NikPanda1537/Proyecto-Robotica-y-Dise-o-mecatronico/README.md

# Robotic_and_Mechatronic_Design_Project
