NikPanda1537/Proyecto-Robotica-y-Dise-o-mecatronico/URDF/Ensamblaje.SLDASM

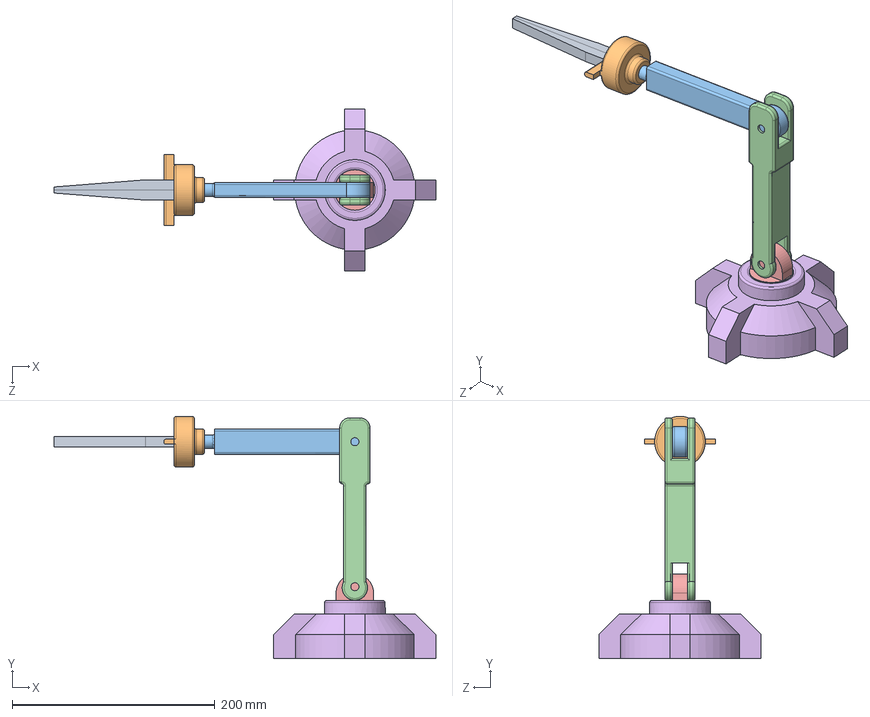
[picture p29: CAD file, 2024-06-11]
URDF/Ensamblaje.SLDASM
376.6 x 238.9 x 160.0 mm
Base
union base eslabon
Eslabon1
Eslabon2
Eslabon pinza
pinza x 2
