NikPanda1537/Proyecto-Robotica-y-Dise-o-mecatronico/Piezas/Cuerpo robot/Encaje_servo.SLDPRT

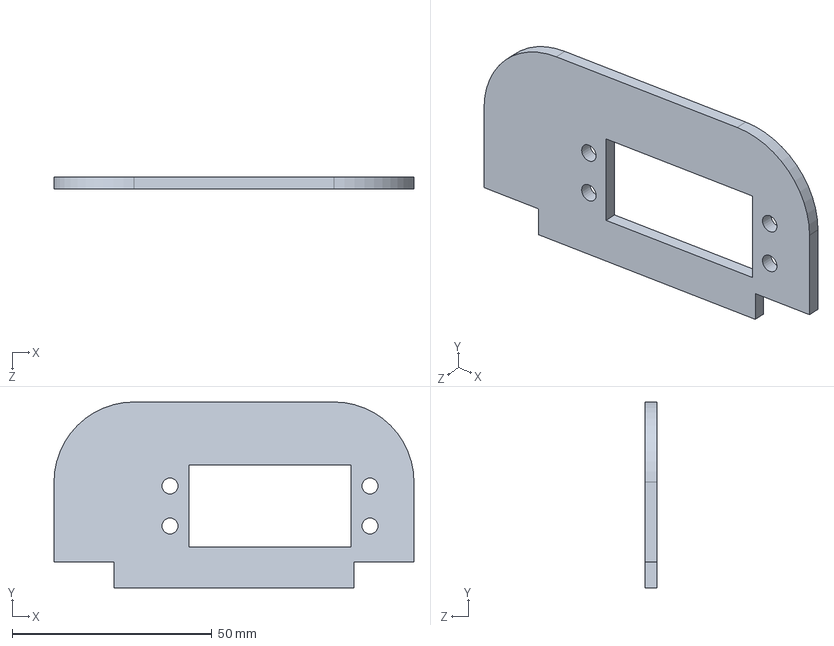
[picture p31: CAD file, 2024-06-11]
Piezas/Cuerpo robot/Encaje_servo.SLDPRT
90.0 x 46.5 x 3.00 mm
