NikPanda1537/Proyecto-Robotica-y-Dise-o-mecatronico/Piezas/Garra/Garra_1.SLDPRT

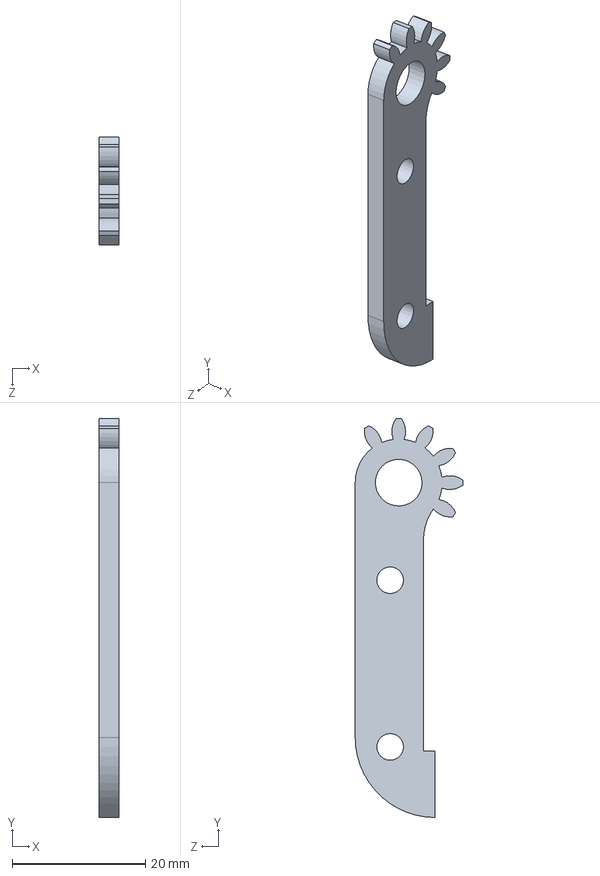
[picture p32: CAD file, 2024-06-11]
Piezas/Garra/Garra_1.SLDPRT
3.00 x 59.8 x 16.1 mm
