NikPanda1537/Proyecto-Robotica-y-Dise-o-mecatronico/Piezas/Tornillos y tuercas/Tornillo.SLDPRT

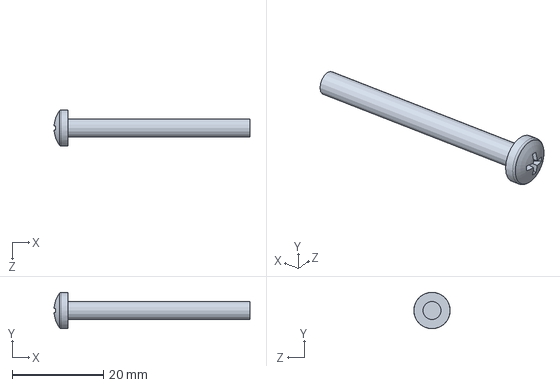
[picture p33: CAD file, 2024-06-11]
Piezas/Tornillos y tuercas/Tornillo.SLDPRT
43.1 x 8.00 x 8.00 mm
