NikPanda1537/Proyecto-Robotica-y-Dise-o-mecatronico/URDF/union base eslabon.SLDPRT

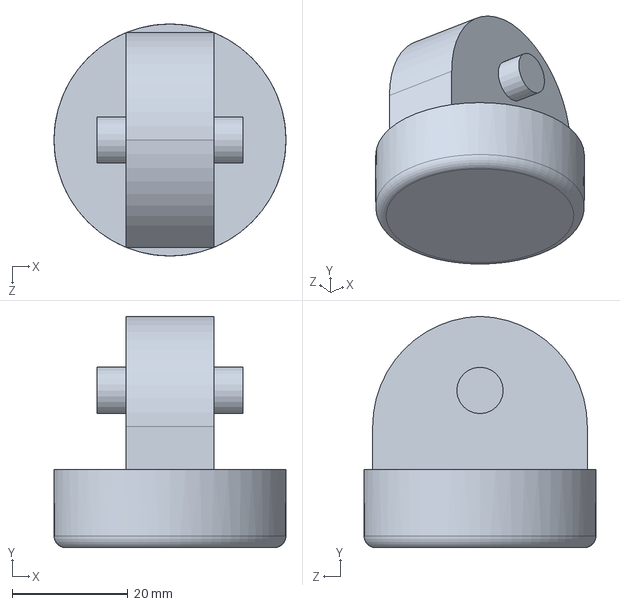
[picture p34: CAD file, 2024-06-11]
URDF/union base eslabon.SLDPRT
40.0 x 39.9 x 40.0 mm
