NikPanda1537/Proyecto-Robotica-y-Dise-o-mecatronico/ws_robot/install/modelo_robot/share/modelo_robot/meshes/Link_5.STL

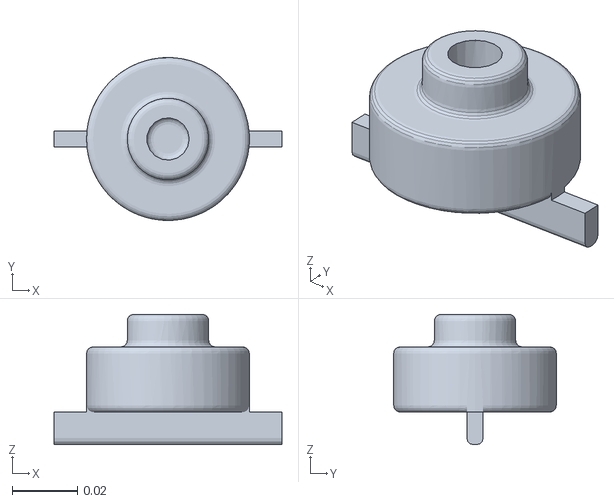
[picture p35: CAD file, 2024-06-12]
ws_robot/install/modelo_robot/share/modelo_robot/meshes/Link_5.STL
0.07 x 0.05 x 0.04
