NikPanda1537/Proyecto-Robotica-y-Dise-o-mecatronico/Piezas/Cuerpo robot/Base_4.SLDPRT

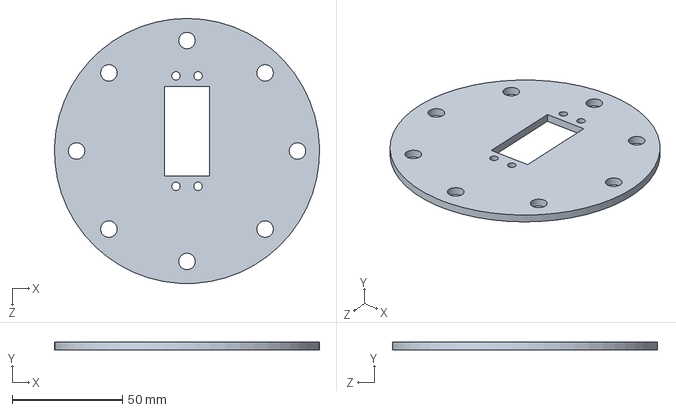
[picture p37: CAD file, 2024-06-11]
Piezas/Cuerpo robot/Base_4.SLDPRT
119.9 x 3.50 x 120.0 mm
