NikPanda1537/Proyecto-Robotica-y-Dise-o-mecatronico/Piezas/Garra/Garra_5.SLDPRT

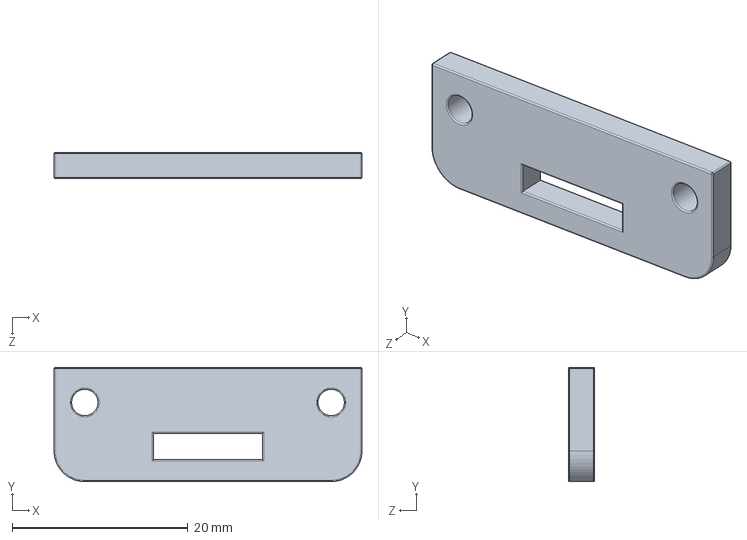
[picture p38: CAD file, 2024-06-11]
Piezas/Garra/Garra_5.SLDPRT
35.0 x 13.0 x 3.00 mm
