NikPanda1537/Proyecto-Robotica-y-Dise-o-mecatronico/Piezas/Tornillos y tuercas/Tornillo3.SLDPRT

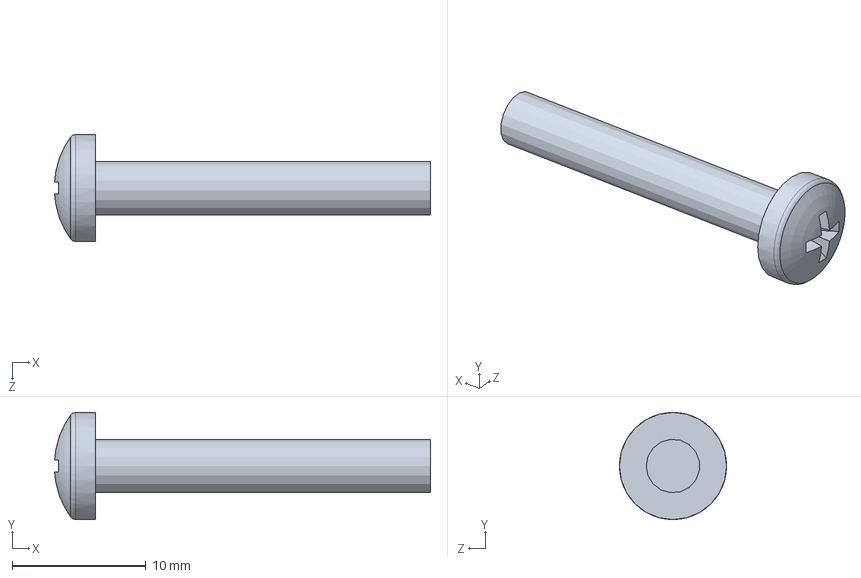
[picture p39: CAD file, 2024-06-11]
Piezas/Tornillos y tuercas/Tornillo3.SLDPRT
28.1 x 8.00 x 8.00 mm
