NikPanda1537/Proyecto-Robotica-y-Dise-o-mecatronico/URDF/Eslabon2.SLDPRT

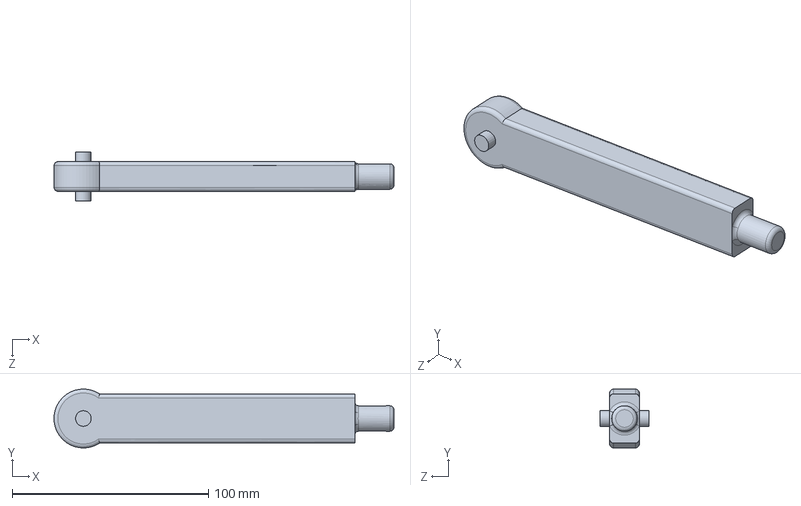
[picture p40: CAD file, 2024-06-11]
URDF/Eslabon2.SLDPRT
173.3 x 30.0 x 25.1 mm
