NikPanda1537/Proyecto-Robotica-y-Dise-o-mecatronico/ws_robot/install/modelo_robot/share/modelo_robot/meshes/base_link.STL

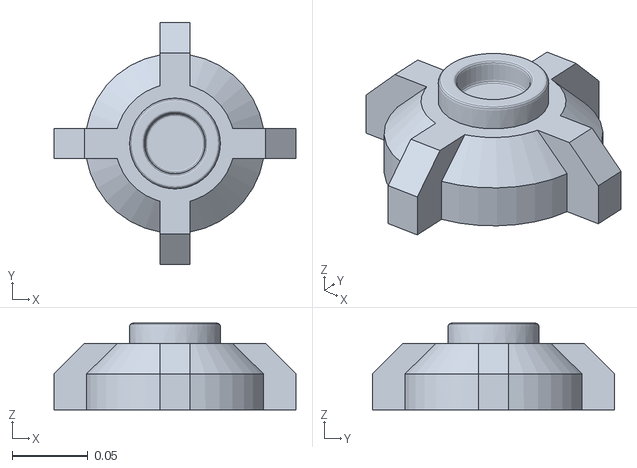
[picture p41: CAD file, 2024-06-11]
ws_robot/install/modelo_robot/share/modelo_robot/meshes/base_link.STL
0.16 x 0.16 x 0.0573
