NikPanda1537/Proyecto-Robotica-y-Dise-o-mecatronico/ws_robot/src/modelo_robot/meshes/Link_6.STL

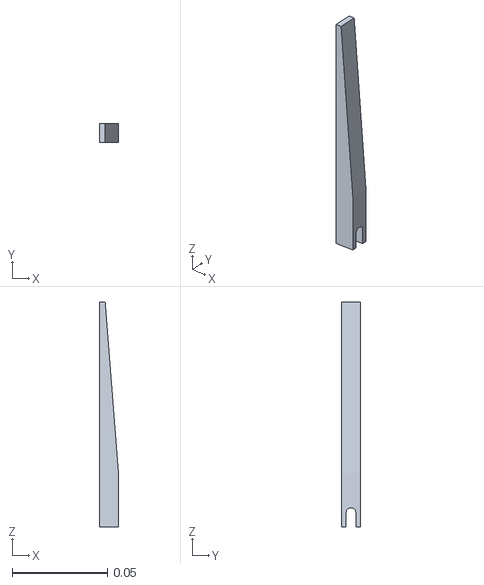
[picture p42: CAD file, 2024-06-11]
ws_robot/src/modelo_robot/meshes/Link_6.STL
0.01 x 0.01 x 0.118
