NikPanda1537/Proyecto-Robotica-y-Dise-o-mecatronico/Piezas/Cuerpo robot/Eslabon4_3.SLDPRT

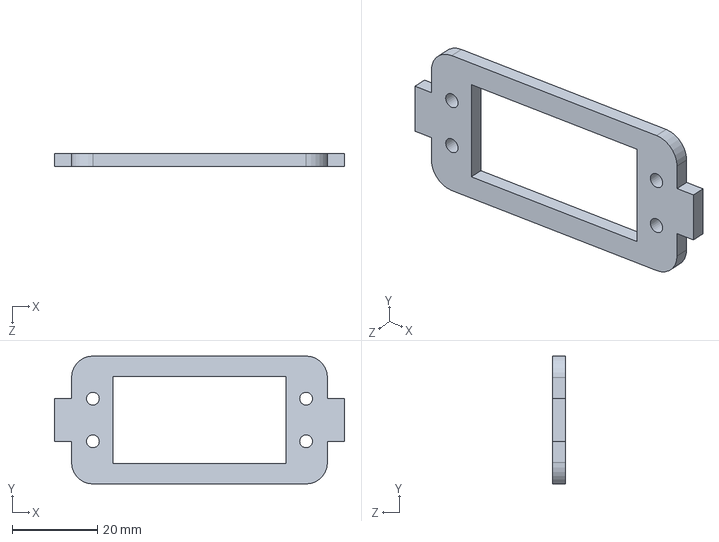
[picture p44: CAD file, 2024-06-11]
Piezas/Cuerpo robot/Eslabon4_3.SLDPRT
68.0 x 30.0 x 3.00 mm
