NikPanda1537/Proyecto-Robotica-y-Dise-o-mecatronico/Piezas/Garra/Garra_4.SLDPRT

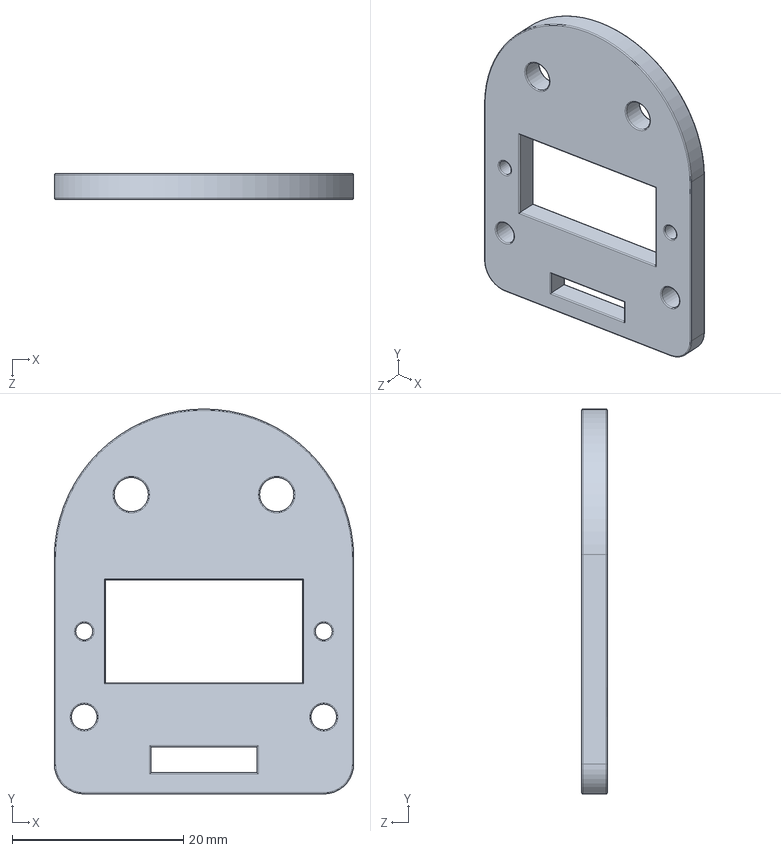
[picture p45: CAD file, 2024-06-11]
Piezas/Garra/Garra_4.SLDPRT
35.0 x 45.0 x 3.00 mm
