NikPanda1537/Proyecto-Robotica-y-Dise-o-mecatronico/Piezas/Tornillos y tuercas/Tornillo2.SLDPRT

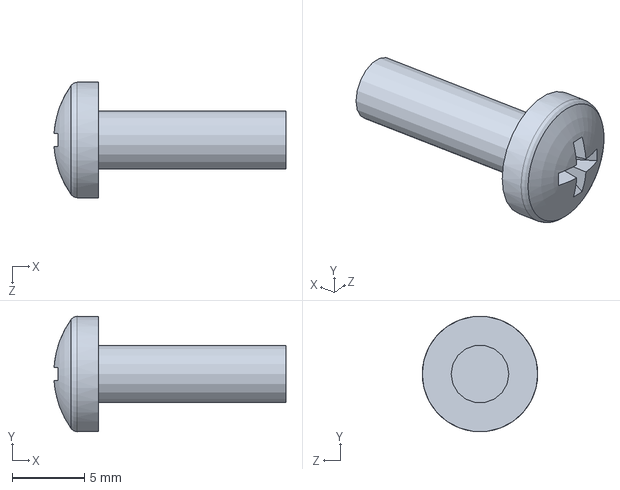
[picture p46: CAD file, 2024-06-11]
Piezas/Tornillos y tuercas/Tornillo2.SLDPRT
16.1 x 8.00 x 8.00 mm
