NikPanda1537/Proyecto-Robotica-y-Dise-o-mecatronico/URDF/Eslabon1.SLDPRT

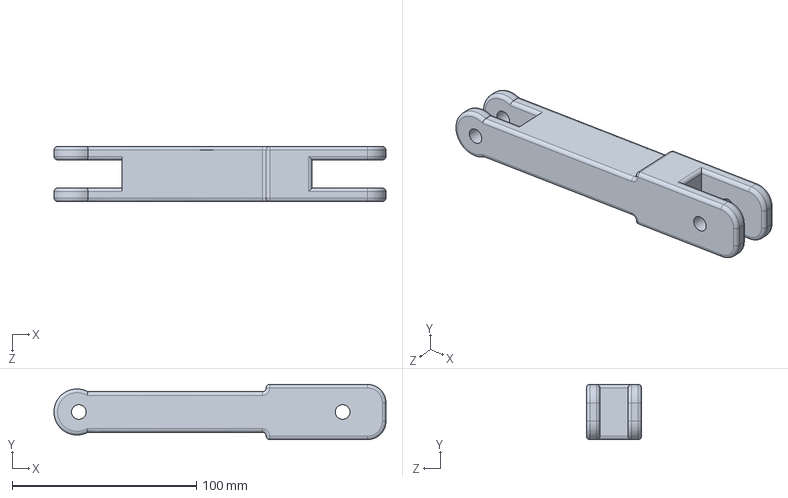
[picture p47: CAD file, 2024-06-11]
URDF/Eslabon1.SLDPRT
180.0 x 30.0 x 30.0 mm
