NikPanda1537/Proyecto-Robotica-y-Dise-o-mecatronico/ws_robot/install/modelo_robot/share/modelo_robot/meshes/Link_3.STL

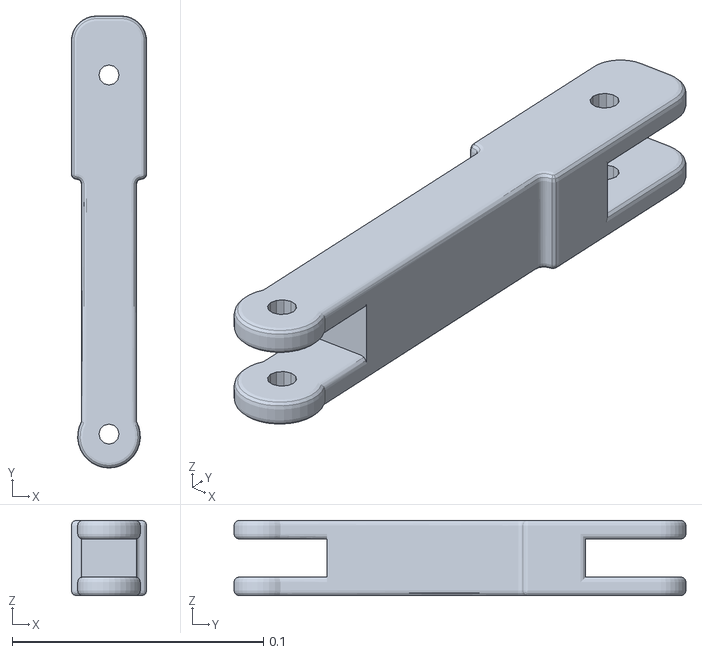
[picture p48: CAD file, 2024-06-11]
ws_robot/install/modelo_robot/share/modelo_robot/meshes/Link_3.STL
0.03 x 0.18 x 0.03
