NikPanda1537/Proyecto-Robotica-y-Dise-o-mecatronico/Piezas/Cuerpo robot/Servomotor.SLDPRT

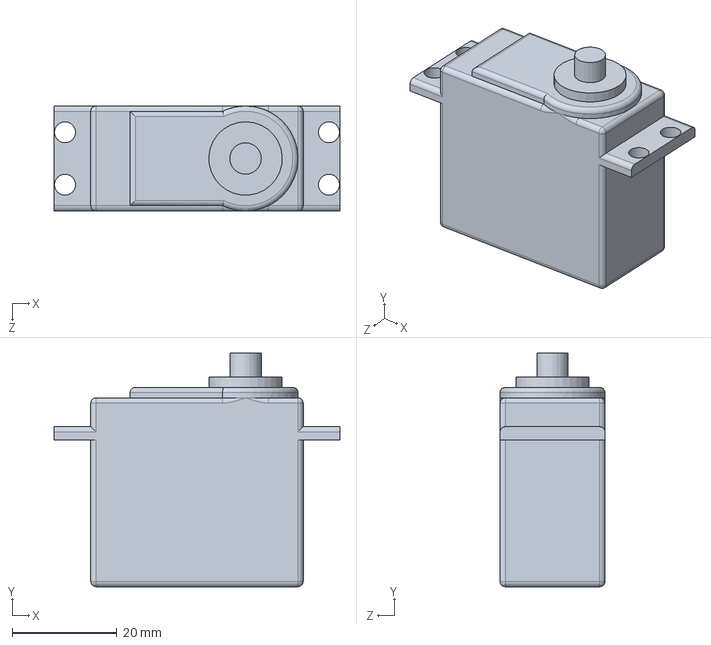
[picture p50: CAD file, 2024-06-11]
Piezas/Cuerpo robot/Servomotor.SLDPRT
54.5 x 44.5 x 20.0 mm
