NikPanda1537/Proyecto-Robotica-y-Dise-o-mecatronico/Piezas/Garra/Garra_6.SLDPRT

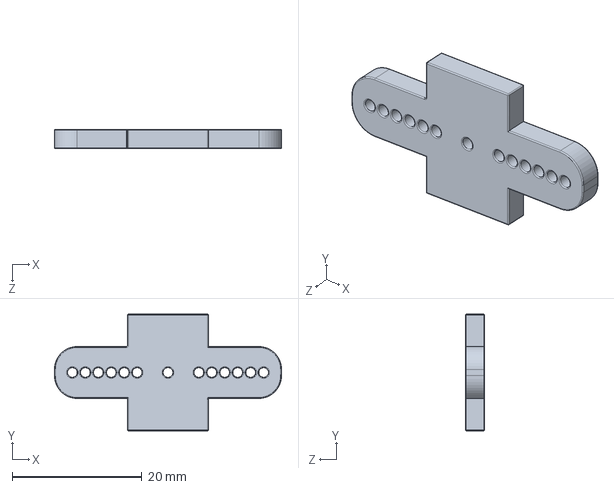
[picture p51: CAD file, 2024-06-11]
Piezas/Garra/Garra_6.SLDPRT
35.0 x 18.0 x 3.00 mm
