NikPanda1537/Proyecto-Robotica-y-Dise-o-mecatronico/Piezas/Tornillos y tuercas/Tuerca.SLDPRT

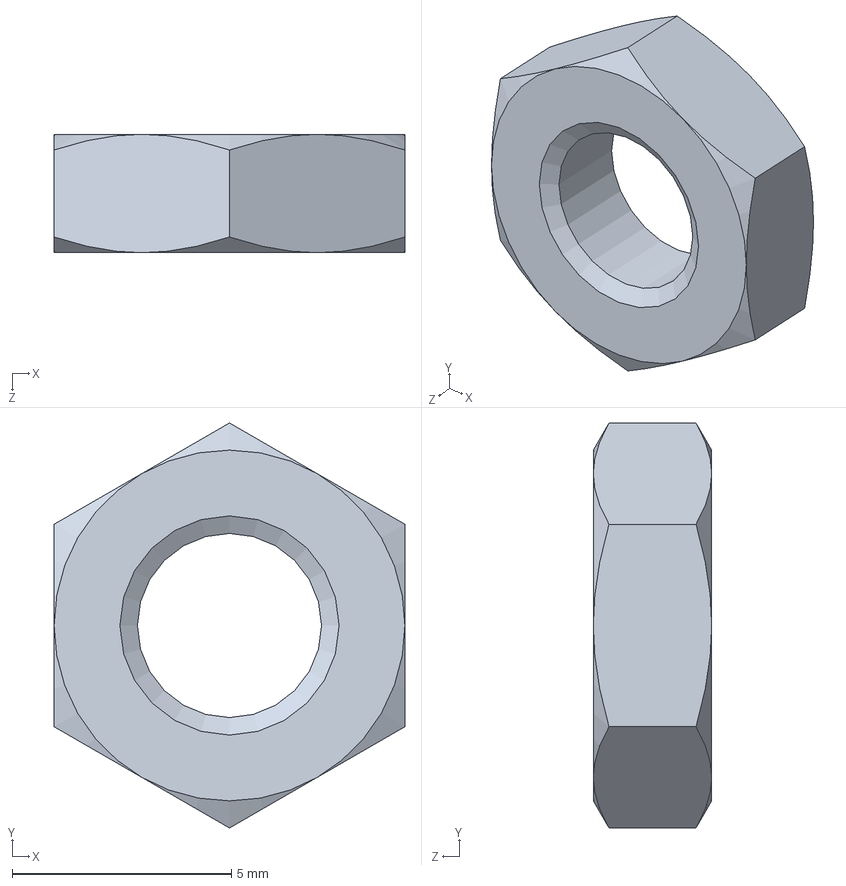
[picture p52: CAD file, 2024-06-11]
Piezas/Tornillos y tuercas/Tuerca.SLDPRT
8.00 x 9.24 x 2.70 mm
