NikPanda1537/Proyecto-Robotica-y-Dise-o-mecatronico/ws_robot/install/modelo_robot/share/modelo_robot/meshes/Link_4.STL

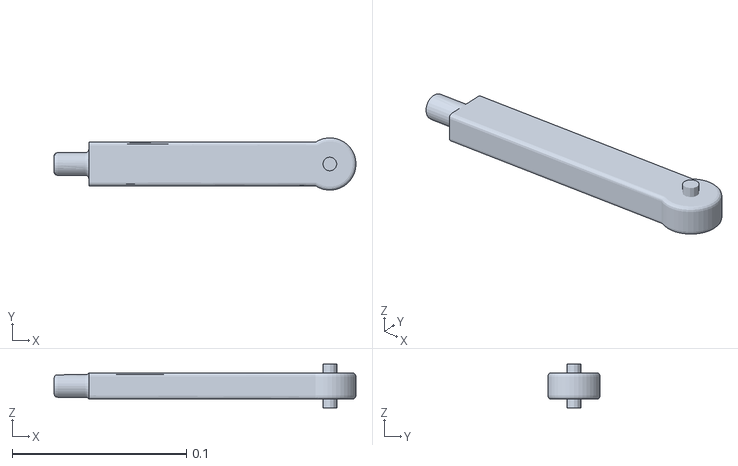
[picture p53: CAD file, 2024-06-11]
ws_robot/install/modelo_robot/share/modelo_robot/meshes/Link_4.STL
0.173 x 0.0299 x 0.0252
