NikPanda1537/Proyecto-Robotica-y-Dise-o-mecatronico/Archivos para Corte laser/Encaje_servo2_3x4.DXF

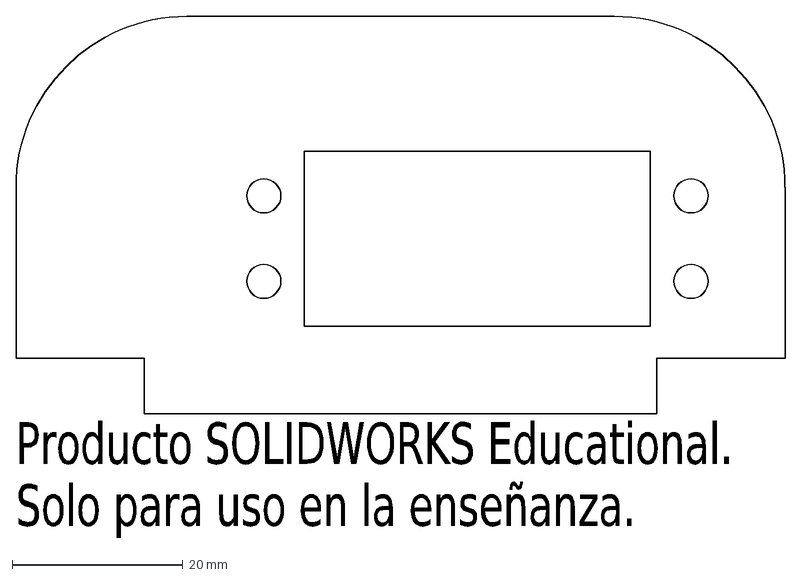
[picture p54: CAD file, 2024-06-11]
Archivos para Corte laser/Encaje_servo2_3x4.DXF
Producto SOLIDWORKS Educational.
Solo para uso en la enseñanza.
