NikPanda1537/Proyecto-Robotica-y-Dise-o-mecatronico/Piezas/Garra/Garra_7.SLDPRT

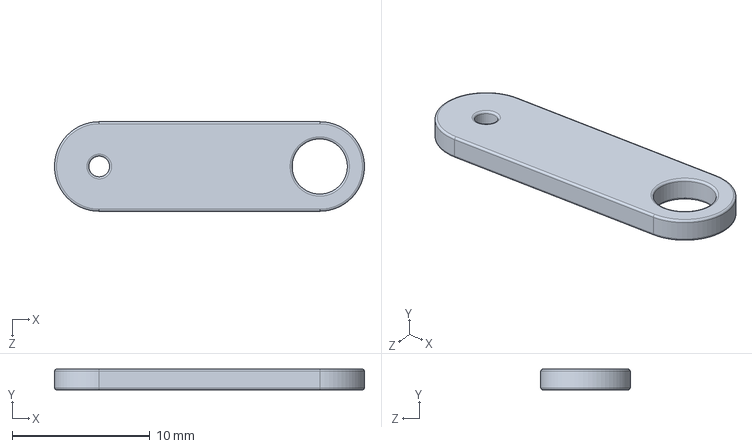
[picture p56: CAD file, 2024-06-11]
Piezas/Garra/Garra_7.SLDPRT
22.5 x 1.50 x 6.50 mm
