NikPanda1537/Proyecto-Robotica-y-Dise-o-mecatronico/URDF/pinza.SLDPRT

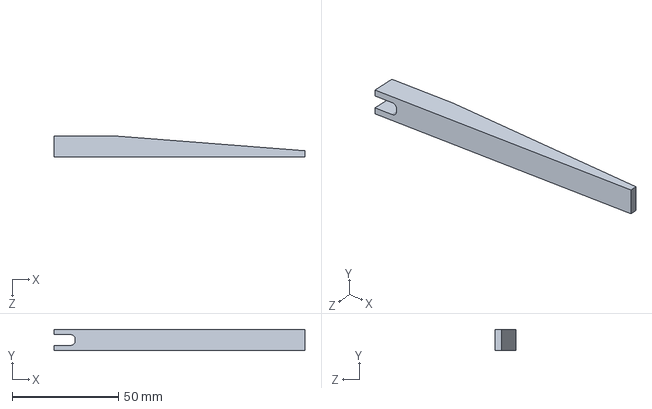
[picture p57: CAD file, 2024-06-11]
URDF/pinza.SLDPRT
118.3 x 10.0 x 10.0 mm
