NikPanda1537/Proyecto-Robotica-y-Dise-o-mecatronico/ws_robot/install/modelo_robot/share/modelo_robot/meshes/Link_2.STL

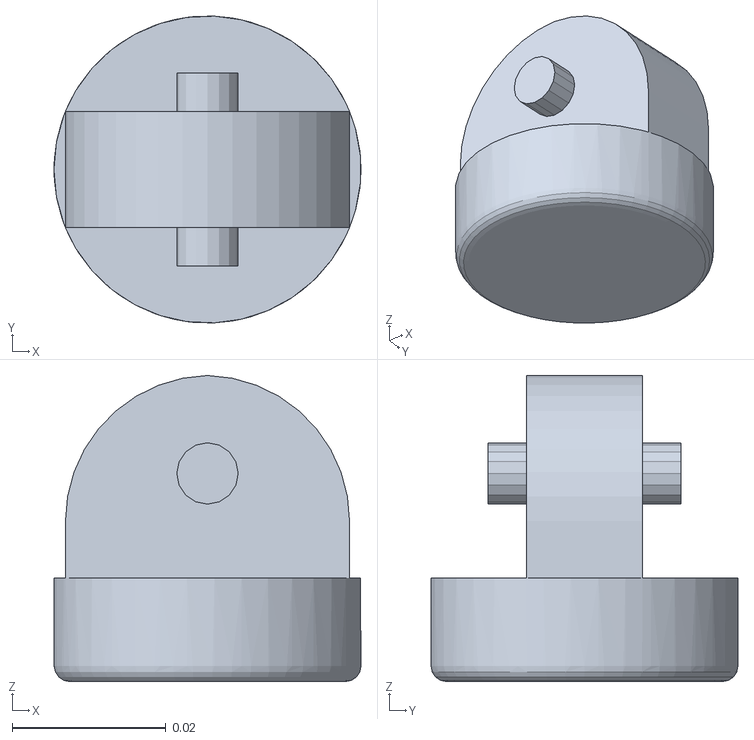
[picture p58: CAD file, 2024-06-11]
ws_robot/install/modelo_robot/share/modelo_robot/meshes/Link_2.STL
0.04 x 0.04 x 0.0399
