NikPanda1537/Proyecto-Robotica-y-Dise-o-mecatronico/Piezas/Cuerpo robot/Eslabon4_1.SLDPRT

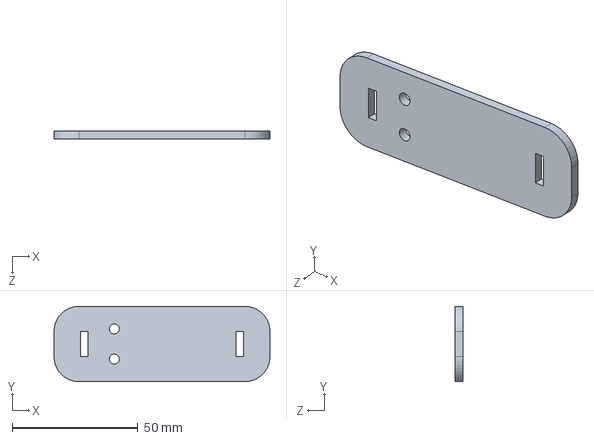
[picture p60: CAD file, 2024-06-11]
Piezas/Cuerpo robot/Eslabon4_1.SLDPRT
86.0 x 30.0 x 3.00 mm
