NikPanda1537/Proyecto-Robotica-y-Dise-o-mecatronico/Piezas/Garra/Garra_3.SLDPRT

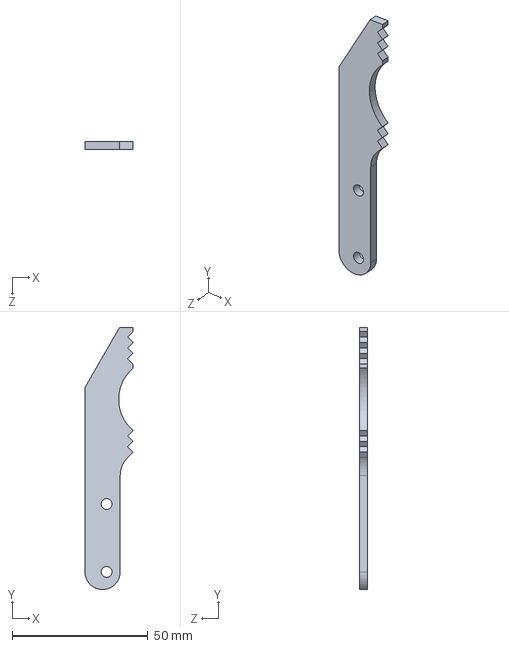
[picture p61: CAD file, 2024-06-11]
Piezas/Garra/Garra_3.SLDPRT
17.8 x 96.5 x 3.00 mm
