NikPanda1537/Proyecto-Robotica-y-Dise-o-mecatronico/URDF/Base.SLDPRT

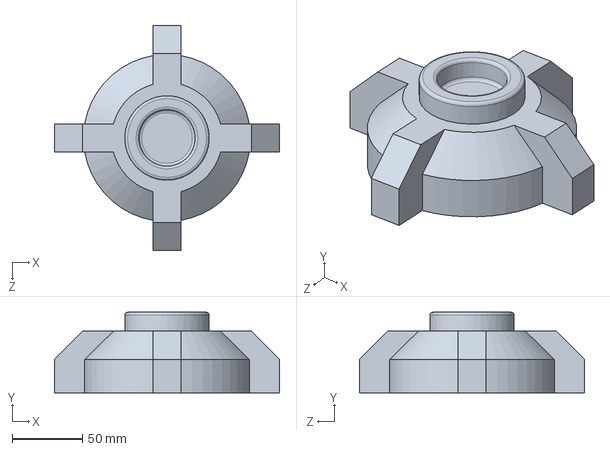
[picture p62: CAD file, 2024-06-11]
URDF/Base.SLDPRT
160.0 x 57.3 x 160.0 mm
