NikPanda1537/Proyecto-Robotica-y-Dise-o-mecatronico/Piezas/Cuerpo robot/Eslabon2_parte2.SLDPRT

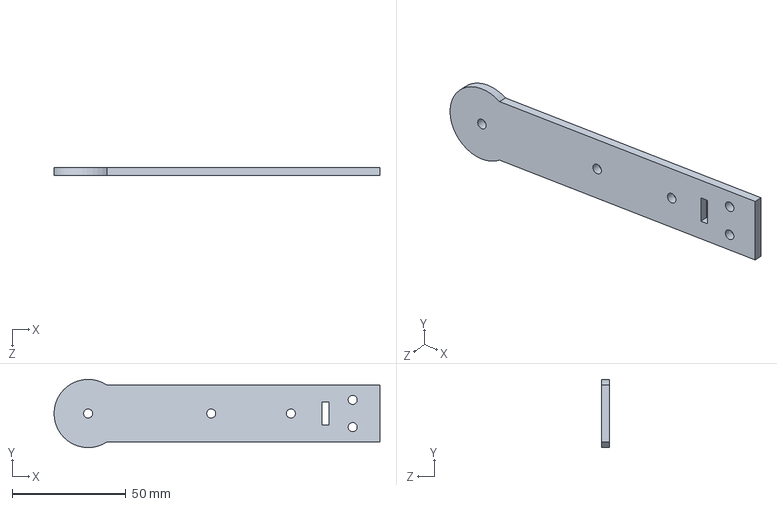
[picture p64: CAD file, 2024-06-11]
Piezas/Cuerpo robot/Eslabon2_parte2.SLDPRT
143.3 x 30.0 x 3.50 mm
