NikPanda1537/Proyecto-Robotica-y-Dise-o-mecatronico/Piezas/Garra/Garra_2.SLDPRT

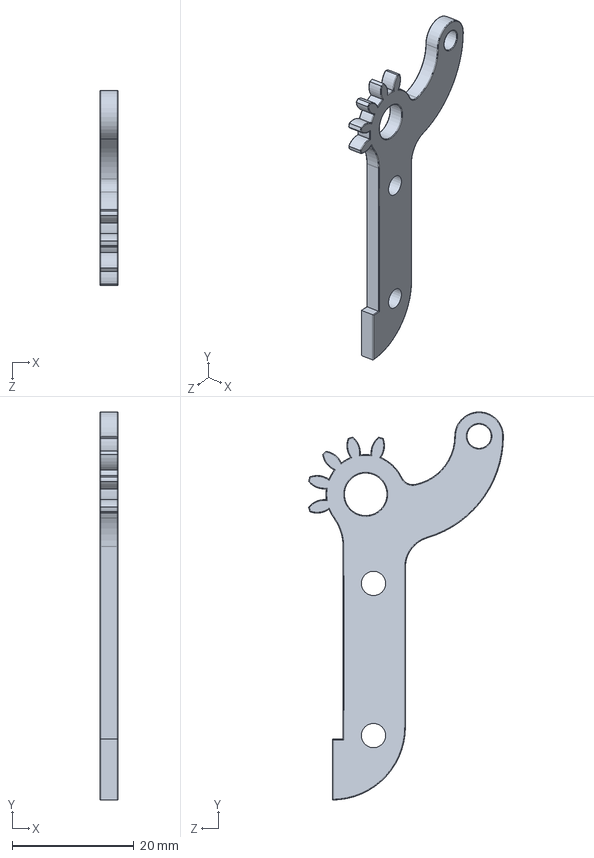
[picture p65: CAD file, 2024-06-11]
Piezas/Garra/Garra_2.SLDPRT
3.00 x 63.8 x 32.0 mm
