NikPanda1537/Proyecto-Robotica-y-Dise-o-mecatronico/URDF/Eslabon pinza.SLDPRT

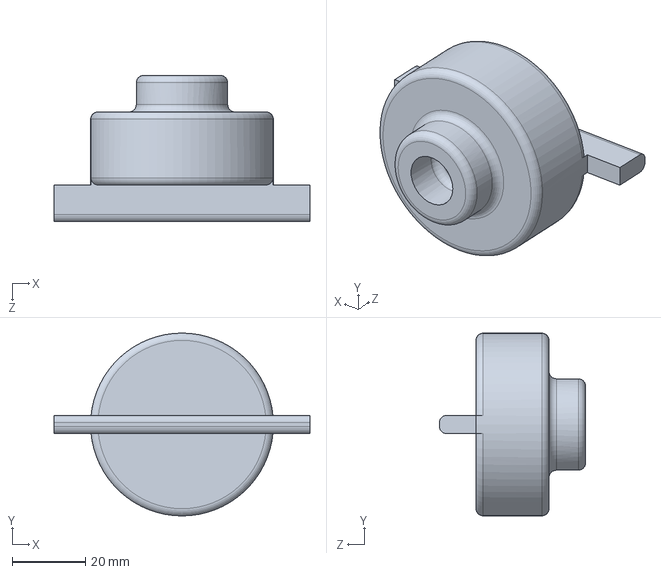
[picture p66: CAD file, 2024-06-11]
URDF/Eslabon pinza.SLDPRT
70.0 x 50.0 x 40.0 mm
