NikPanda1537/Proyecto-Robotica-y-Dise-o-mecatronico/Piezas/Cuerpo robot/Base_articulacion_1.SLDPRT

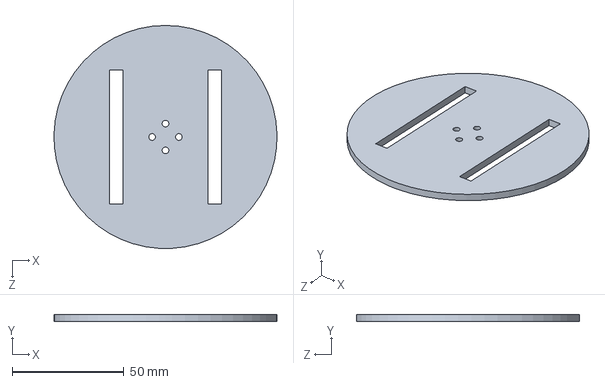
[picture p68: CAD file, 2024-06-11]
Piezas/Cuerpo robot/Base_articulacion_1.SLDPRT
100.0 x 3.00 x 100.0 mm
