NikPanda1537/Proyecto-Robotica-y-Dise-o-mecatronico/Piezas/Cuerpo robot/Eslabon1_parte1.SLDPRT

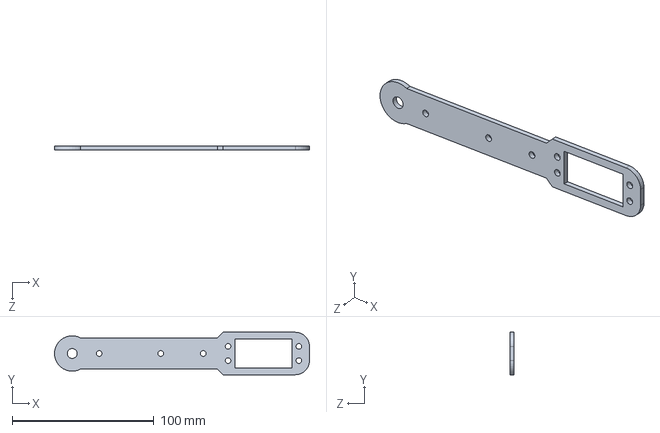
[picture p71: CAD file, 2024-06-11]
Piezas/Cuerpo robot/Eslabon1_parte1.SLDPRT
180.0 x 30.0 x 3.00 mm
