NikPanda1537/Proyecto-Robotica-y-Dise-o-mecatronico/Archivos para Corte laser/PTN8x1.DXF

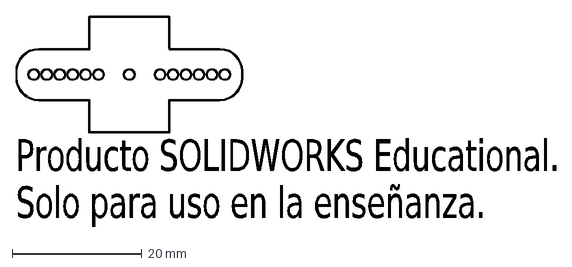
[picture p74: CAD file, 2024-06-11]
Archivos para Corte laser/PTN8x1.DXF
Producto SOLIDWORKS Educational.
Solo para uso en la enseñanza.
