NikPanda1537/Proyecto-Robotica-y-Dise-o-mecatronico/Piezas/Cuerpo robot/Eslabon4_2.SLDPRT

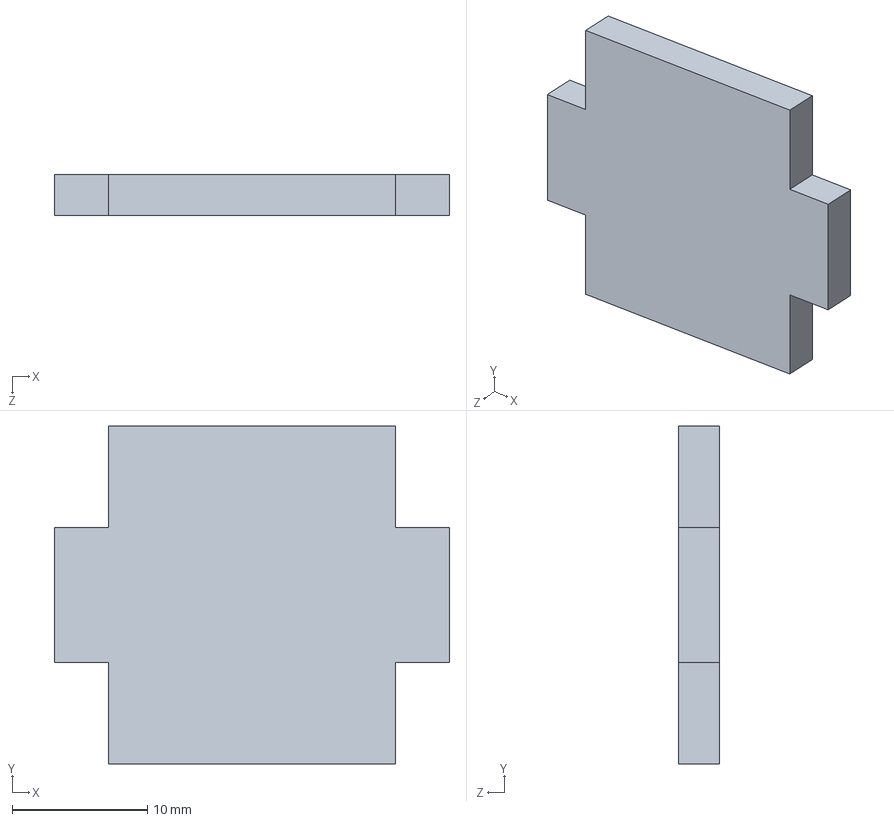
[picture p75: CAD file, 2024-06-11]
Piezas/Cuerpo robot/Eslabon4_2.SLDPRT
29.2 x 25.0 x 3.00 mm
