NikPanda1537/Proyecto-Robotica-y-Dise-o-mecatronico/Archivos para Corte laser/PTN4_x1.DXF

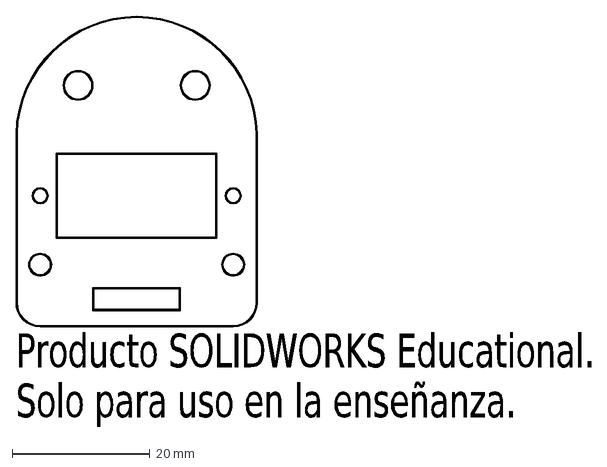
[picture p76: CAD file, 2024-06-11]
Archivos para Corte laser/PTN4_x1.DXF
Producto SOLIDWORKS Educational.
Solo para uso en la enseñanza.
