NikPanda1537/Proyecto-Robotica-y-Dise-o-mecatronico/Piezas/Cuerpo robot/Base_2.SLDPRT

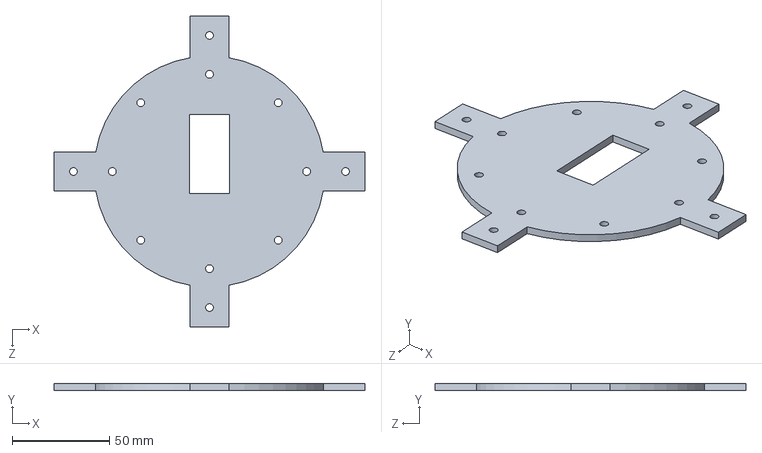
[picture p77: CAD file, 2024-06-11]
Piezas/Cuerpo robot/Base_2.SLDPRT
160.0 x 3.50 x 160.0 mm
