NikPanda1537/Proyecto-Robotica-y-Dise-o-mecatronico/Archivos para Corte laser/Base_articulacion1x2.DXF

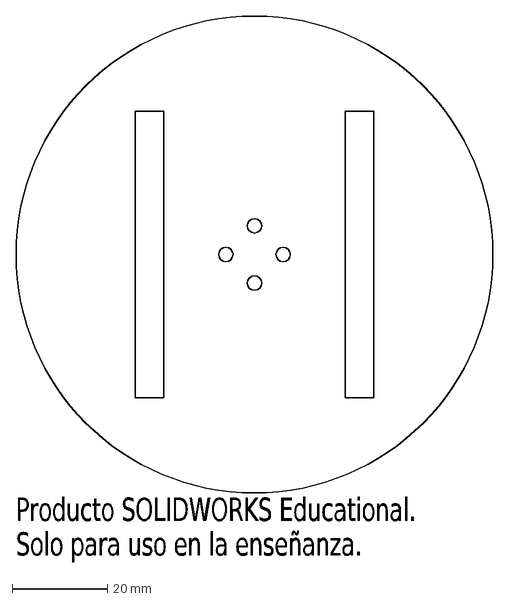
[picture p79: CAD file, 2024-06-11]
Archivos para Corte laser/Base_articulacion1x2.DXF
Producto SOLIDWORKS Educational.
Solo para uso en la enseñanza.
