NikPanda1537/Proyecto-Robotica-y-Dise-o-mecatronico/Archivos para Corte laser/Eslabon4_1x2.DXF

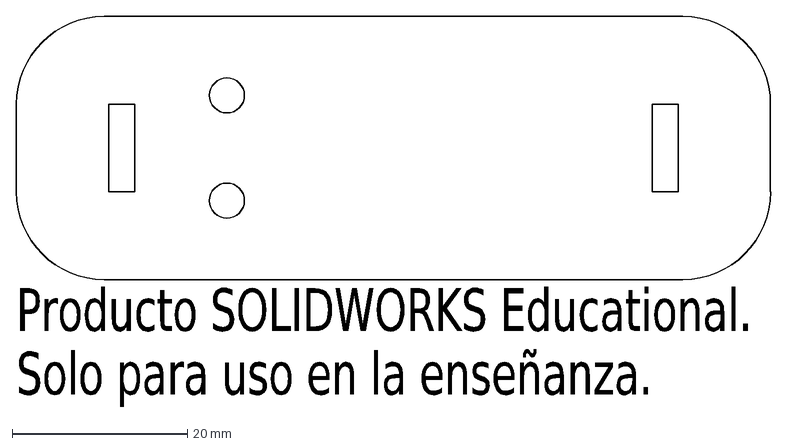
[picture p82: CAD file, 2024-06-11]
Archivos para Corte laser/Eslabon4_1x2.DXF
Producto SOLIDWORKS Educational.
Solo para uso en la enseñanza.
