NikPanda1537/Proyecto-Robotica-y-Dise-o-mecatronico/Archivos para Corte laser/Eslabon2_parte2x1.DXF

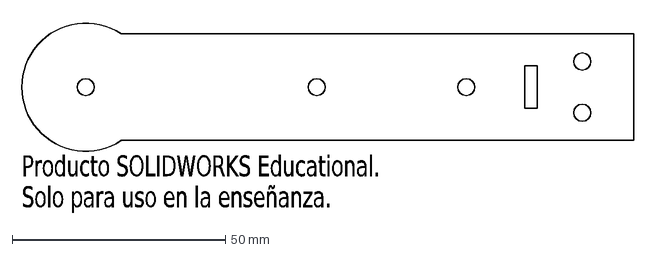
[picture p83: CAD file, 2024-06-11]
Archivos para Corte laser/Eslabon2_parte2x1.DXF
Producto SOLIDWORKS Educational.
Solo para uso en la enseñanza.
