NikPanda1537/Proyecto-Robotica-y-Dise-o-mecatronico/Archivos para Corte laser/eslabon4_2x2.DXF

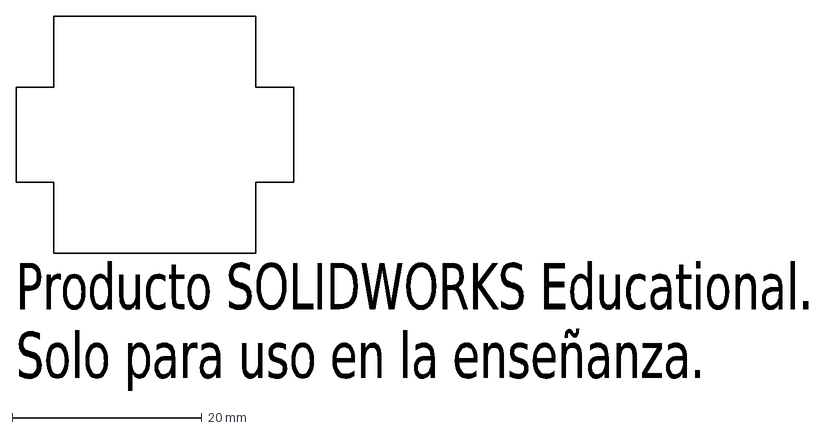
[picture p85: CAD file, 2024-06-11]
Archivos para Corte laser/eslabon4_2x2.DXF
Producto SOLIDWORKS Educational.
Solo para uso en la enseñanza.
