NikPanda1537/Proyecto-Robotica-y-Dise-o-mecatronico/Piezas/Ensamble/Ensamblaje Proyecto.SLDASM

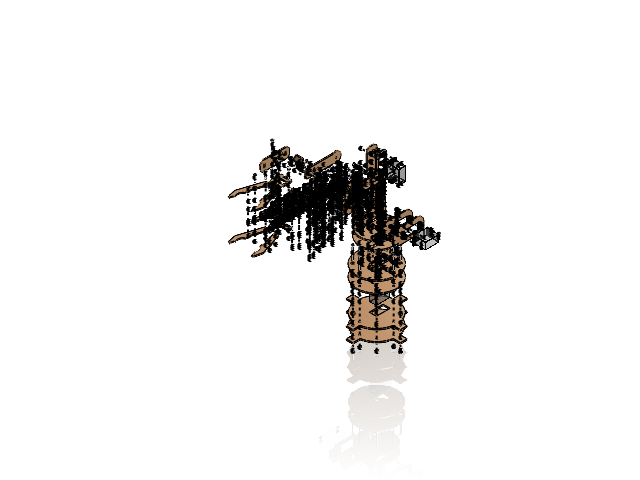
[picture p86: CAD file, 2024-06-12]
Piezas/Ensamble/Ensamblaje Proyecto.SLDASM
Base_1
Base_2
Base_3
Base_4
Base_articulacion_1 x 2
Encaje_servo x 4
Eslabon1_parte1
Eslabon1_parte2
Eslabon2_Parte1
Eslabon2_parte2
Eslabon4_1 x 2
Eslabon4_2 x 2
Eslabon4_3
Garra_2
Garra_3 x 4
Garra_4
Garra_5
Garra_6
Garra_7
Garra_8 x 2
Servomotor x 5
pan cross head_am x 49
hex nut jam_am x 65
engrane servo
punta x 2
Garra_1
carcasa
carcasa 2 servo
cover servo
engranaje servo
