NikPanda1537/Proyecto-Robotica-y-Dise-o-mecatronico/(list of files, cad)

Other CAD files:
ws_robot/src/modelo_robot/meshes/Link_7.STL
ws_robot/install/modelo_robot/share/modelo_robot/meshes/Link_7.STL
Piezas/Cuerpo robot/Base_3.SLDPRT
Piezas/Cuerpo robot/Eslabon2_Parte1.SLDPRT
Planos/Planos individuales/Cuerpo robot/Base_1.SLDDRW
Planos/Planos individuales/Cuerpo robot/Base_2.SLDDRW
Planos/Planos individuales/Cuerpo robot/Base_3.SLDDRW
Planos/Planos individuales/Cuerpo robot/Base_4.SLDDRW
Planos/Planos individuales/Cuerpo robot/Base_articulacion1.SLDDRW
Planos/Planos individuales/Cuerpo robot/Encaje_servo.SLDDRW
Planos/Planos individuales/Cuerpo robot/Eslabon1_parte1.SLDDRW
Planos/Planos individuales/Cuerpo robot/Eslabon1_parte2.SLDDRW
Planos/Planos individuales/Cuerpo robot/Eslabon2_parte1.SLDDRW
Planos/Planos individuales/Cuerpo robot/Eslabon2_parte2.SLDDRW
Planos/Planos individuales/Cuerpo robot/Eslabon4_1.SLDDRW
Planos/Planos individuales/Cuerpo robot/Servomotor.SLDDRW
Planos/Planos individuales/Cuerpo robot/eslabon4_2.SLDDRW
Planos/Planos individuales/Cuerpo robot/eslabon4_3.SLDDRW
Planos/Planos individuales/Ensamble/Plano, ensamblaje.SLDDRW
Planos/Planos individuales/Ensamble/Vista explosionada.SLDDRW
Planos/Planos individuales/Garra/Garra_1.SLDDRW
Planos/Planos individuales/Garra/Garra_2.SLDDRW
Planos/Planos individuales/Garra/Garra_3.SLDDRW
Planos/Planos individuales/Garra/Garra_4.SLDDRW
Planos/Planos individuales/Garra/Garra_5.SLDDRW
Planos/Planos individuales/Garra/Garra_6.SLDDRW
Planos/Planos individuales/Garra/Garra_7.SLDDRW
