NikPanda1537/Proyecto-Robotica-y-Dise-o-mecatronico/Planos/Pdf con todos los planos/Todos los planos.pdf

23

8

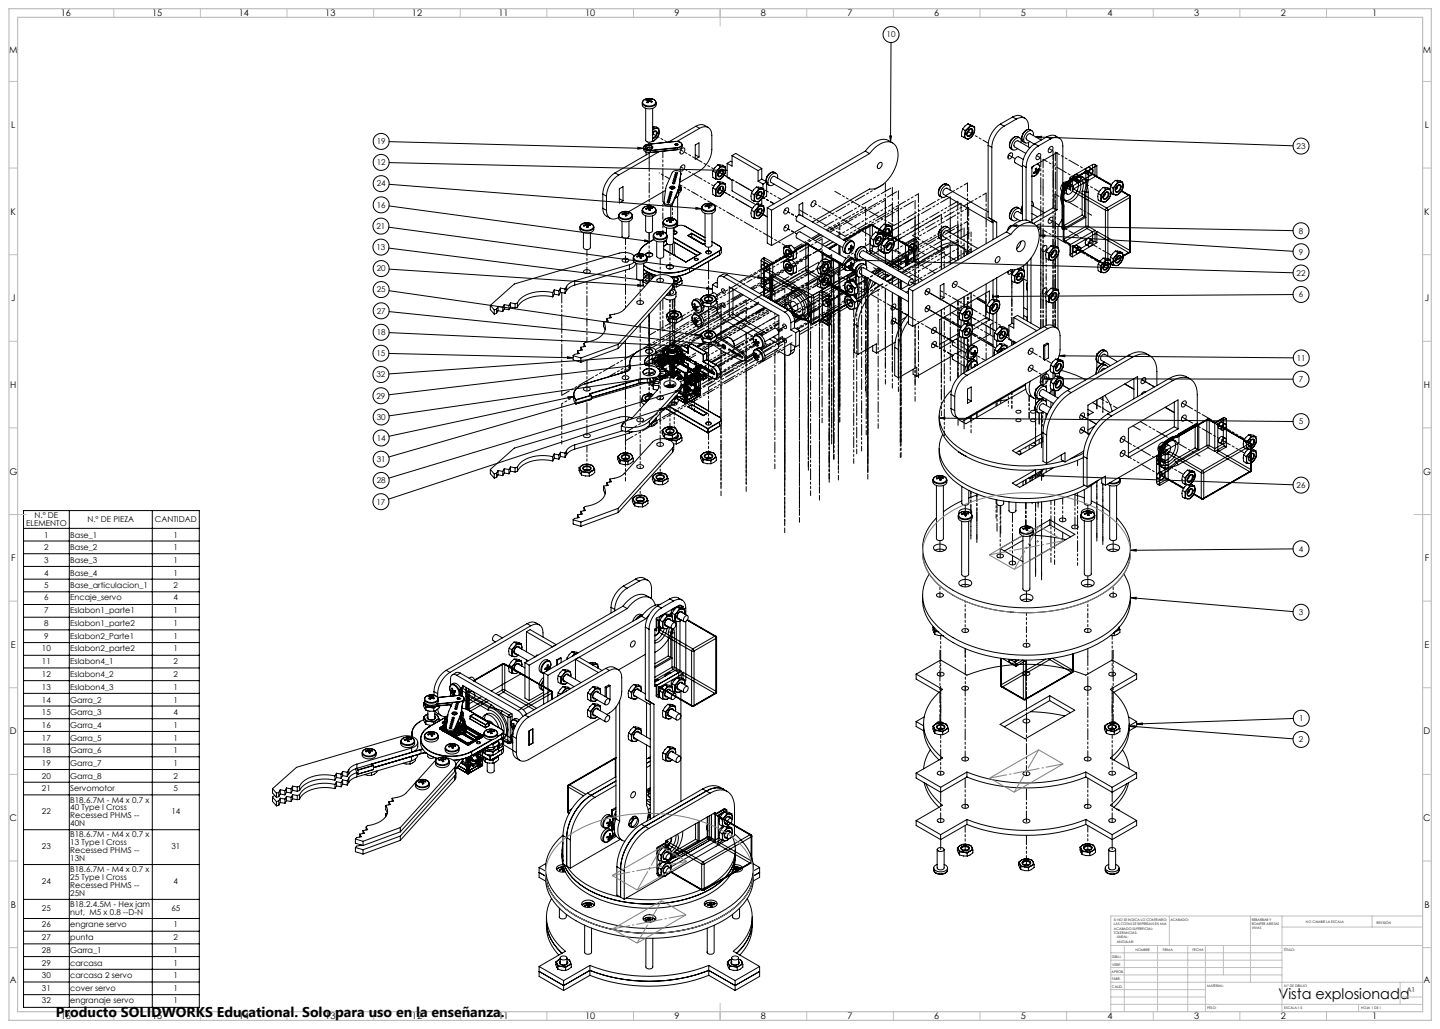
[picture p87: page 1]
cover servo; engranaje servo; CALID.; ACABADO:; REBARBAR Y; ROMPER ARISTAS VIVAS; MATERIAL:; NO CAMBIE LA ESCALA; REVISIÓN; N.º DE DIBUJO; ESCALA:1:5; HOJA 1 DE 1; PESO:; Vista explosionada

N.º DE ELEMENTO | N.º DE PIEZA | CANTIDAD
1 | Base_1 | 1
2 | Base_2 | 1
3 | Base_3 | 1
4 | Base_4 | 1
5 | Base_articulacion_1 | 2
6 | Encaje_servo | 4
7 | Eslabon1_parte1 | 1
8 | Eslabon1_parte2 | 1
9 | Eslabon2_Parte1 | 1
10 | Eslabon2_parte2 | 1
11 | Eslabon4_1 | 2
12 | Eslabon4_2 | 2
13 | Eslabon4_3 | 1
14 | Garra_2 | 1
15 | Garra_3 | 4
16 | Garra_4 | 1
17 | Garra_5 | 1
18 | Garra_6 | 1
19 | Garra_7 | 1
20 | Garra_8 | 2
21 | Servomotor | 5
22 | B18.6.7M - M4 x 0.7 x 40 Type I Cross Recessed PHMS --40N | 14

23 | B18.6.7M - M4 x 0.7 x 13 Type I Cross Recessed PHMS --13N | 31

24 | B18.6.7M - M4 x 0.7 x 25 Type I Cross Recessed PHMS --25N | 4

25 | B18.2.4.5M - Hex jam nut, M5 x 0.8 --D-N | 65
26 | engrane servo | 1
27 | punta | 2
28 | Garra_1 | 1
29 | carcasa | 1
30 | carcasa 2 servo | 1

SI NO SE INDICA LO CONTRARIO:
LAS COTAS SE EXPRESAN EN MM
ACABADO SUPERFICIAL:
TOLERANCIAS:
LINEAL:
ANGULAR:

NOMBRE | FIRMA | FECHA | TÍTULO:

DIBUJ.
VERIF.
APROB.
FABR.

Producto SOLIDWORKS Educational. Solo para uso en la enseñanza.

5,50

G | G

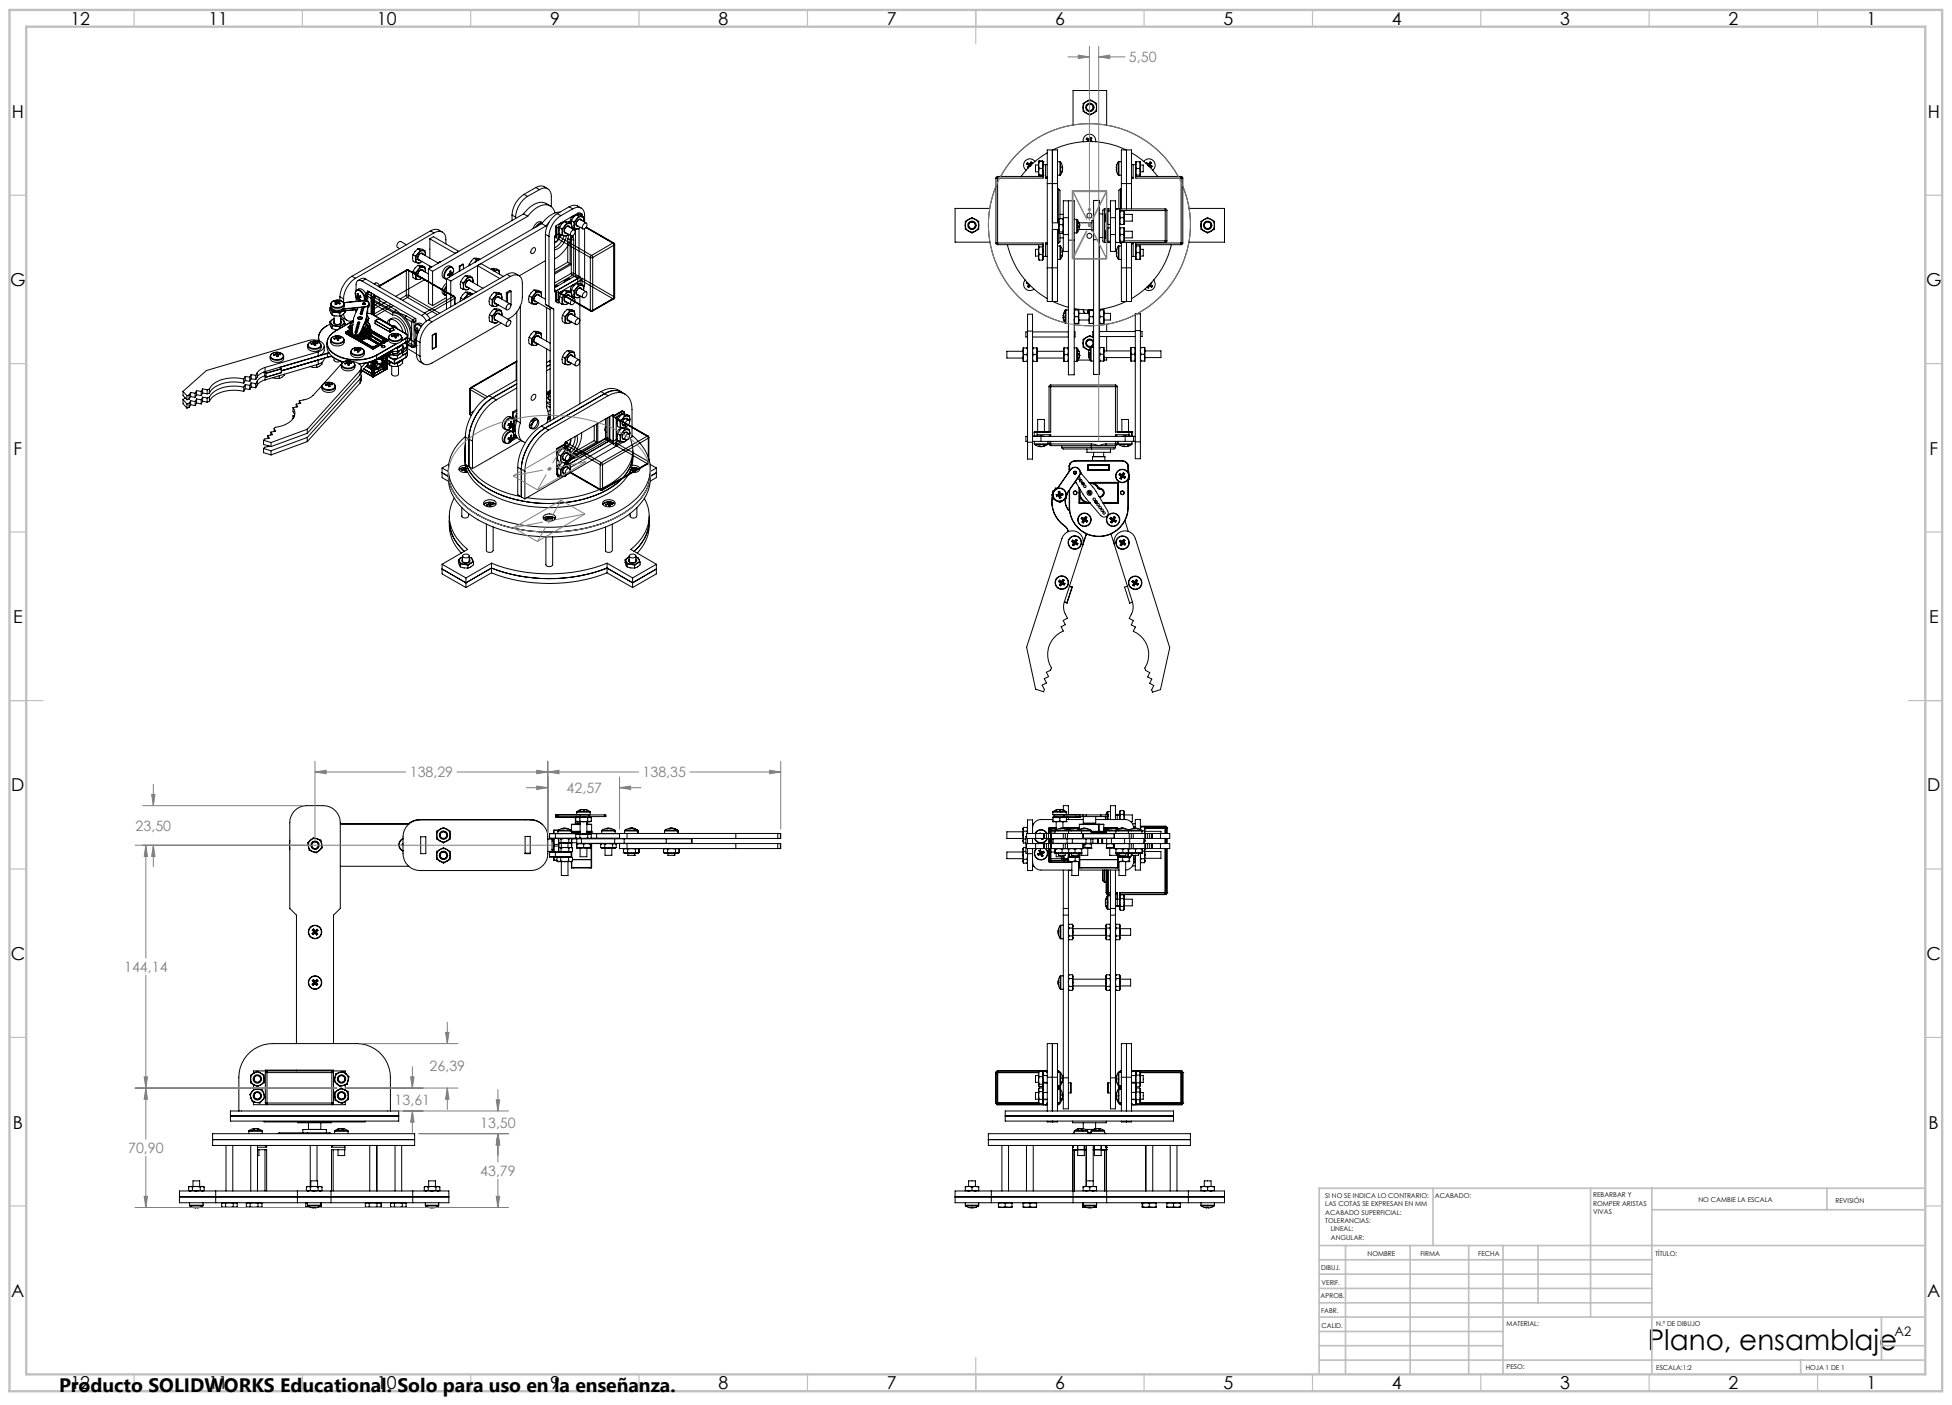
[picture p88: page 2]
ACABADO:; REBARBAR Y; ROMPER ARISTAS VIVAS; NO CAMBIE LA ESCALA; REVISIÓN

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

NOMBRE | FIRMA | FECHA | | | | TÍTULO:

DIBUJ.
VERIF.
APROB.
FABR.

MATERIAL: Plano, ensamblaje

ESCALA:1:2 | HOJA 1 DE 1

4,46 | 7,00 8,00 12 X 0,40

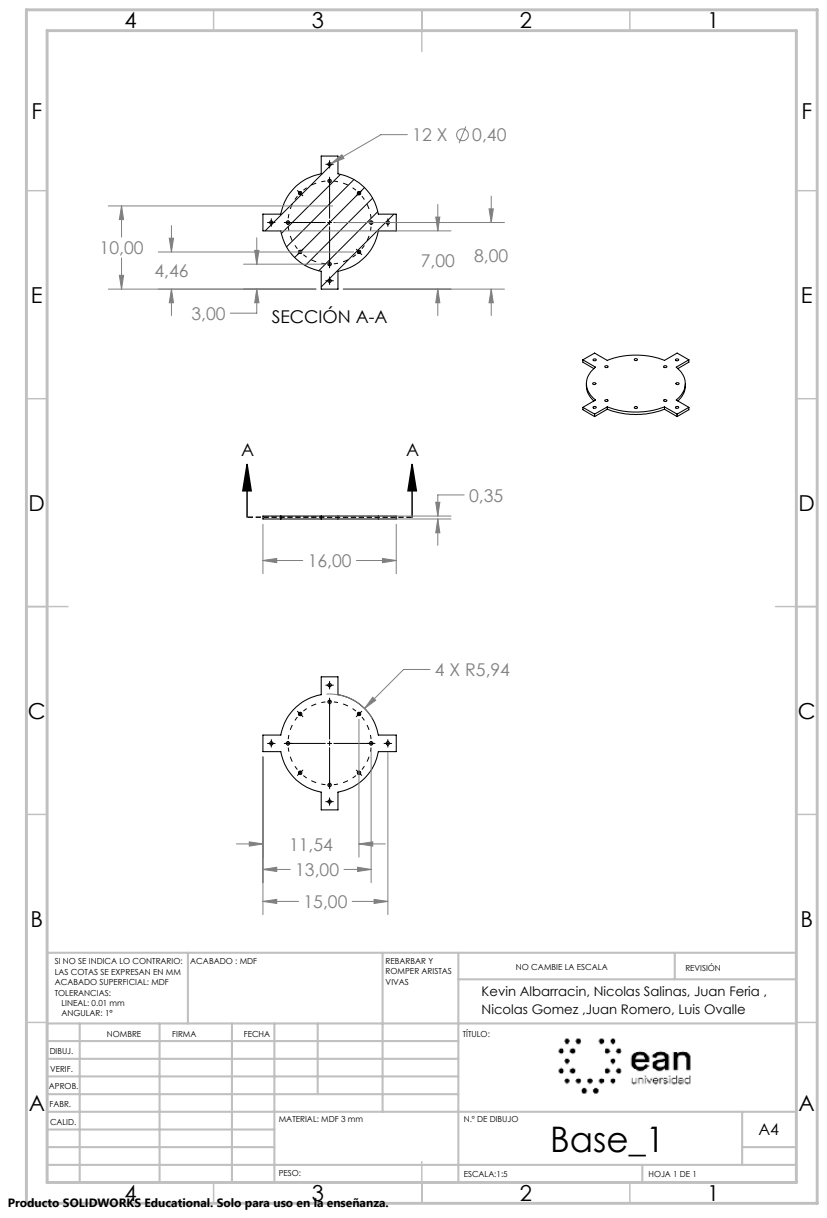
[picture p89: page 3]
SECCIÓN A-A; ACABADO : MDF; REBARBAR Y; ROMPER ARISTAS VIVAS; NO CAMBIE LA ESCALA; REVISIÓN

SI NO SE INDICA LO CONTRARIO:
LAS COTAS SE EXPRESAN EN MM
ACABADO SUPERFICIAL: MDF
TOLERANCIAS:
LINEAL: 0.01 mm
ANGULAR: 1°

Kevin Albarracin, Nicolas Salinas, Juan Feria ,
Nicolas Gomez ,Juan Romero, Luis Ovalle

NOMBRE | FIRMA | FECHA | | | | TÍTULO:

DIBUJ.
VERIF.
APROB.
FABR.

MATERIAL: MDF 3 mm | Base_1

ESCALA:1:5 | HOJA 1 DE 1

7,00

8,00

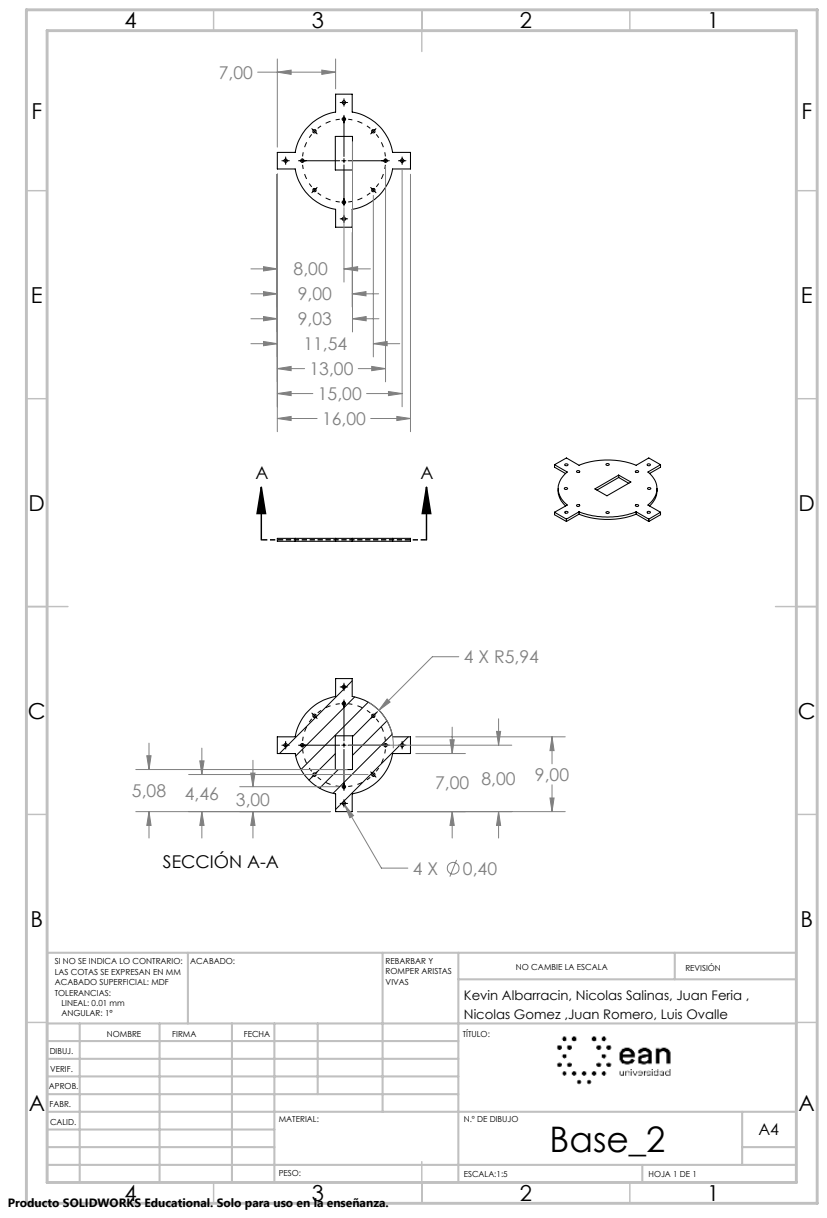
[picture p90: page 4]
SECCIÓN A-A; ACABADO:; REBARBAR Y; ROMPER ARISTAS VIVAS; NO CAMBIE LA ESCALA; REVISIÓN

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

Kevin Albarracin, Nicolas Salinas, Juan Feria ,
Nicolas Gomez ,Juan Romero, Luis Ovalle

NOMBRE | FIRMA | FECHA | | | | TÍTULO:

DIBUJ.
VERIF.
APROB.
FABR.

MATERIAL: | Base_2

ESCALA:1:5 | HOJA 1 DE 1

0,35
E | E

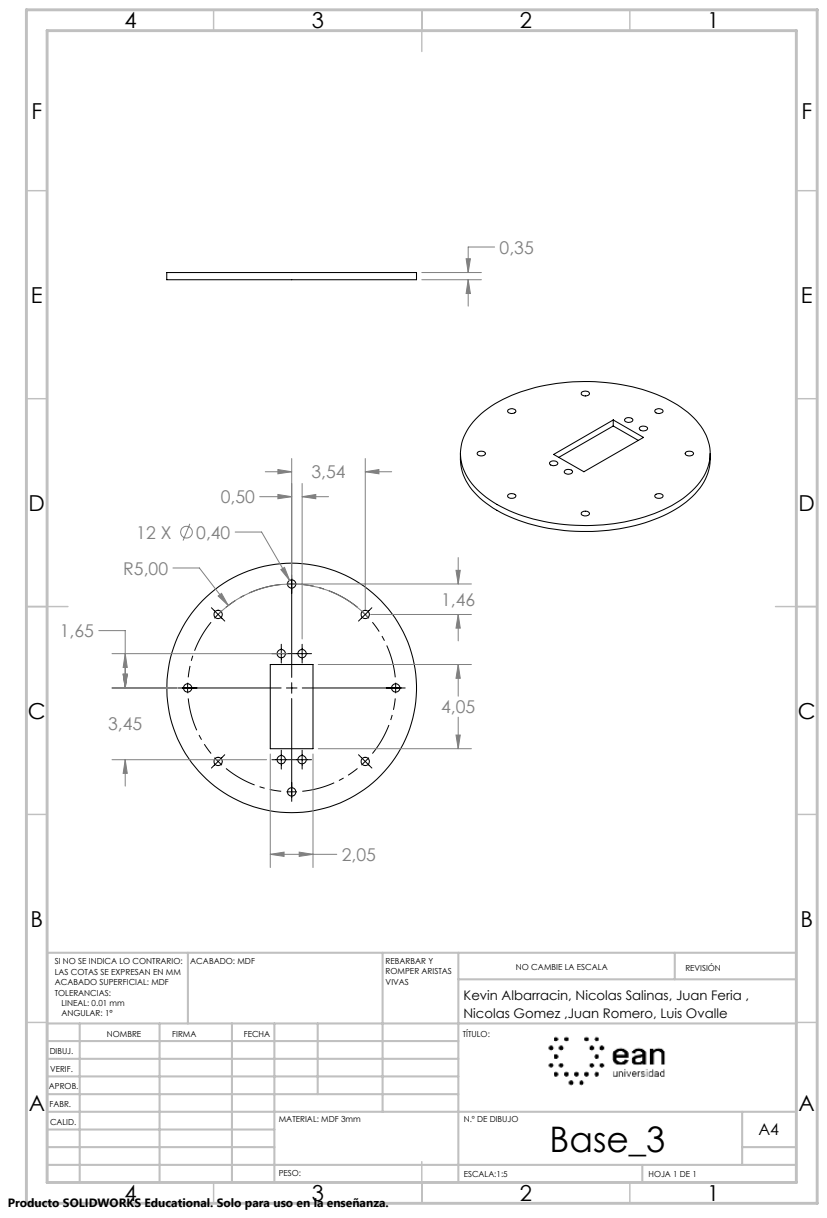
[picture p91: page 5]
ACABADO: MDF; REBARBAR Y; ROMPER ARISTAS VIVAS; NO CAMBIE LA ESCALA; REVISIÓN

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

Kevin Albarracin, Nicolas Salinas, Juan Feria ,
Nicolas Gomez ,Juan Romero, Luis Ovalle

NOMBRE | FIRMA | FECHA | | | | TÍTULO:

DIBUJ.
VERIF.
APROB.
FABR.

MATERIAL: MDF 3mm | Base_3

ESCALA:1:5 | HOJA 1 DE 1

12 X 0,75

3,54

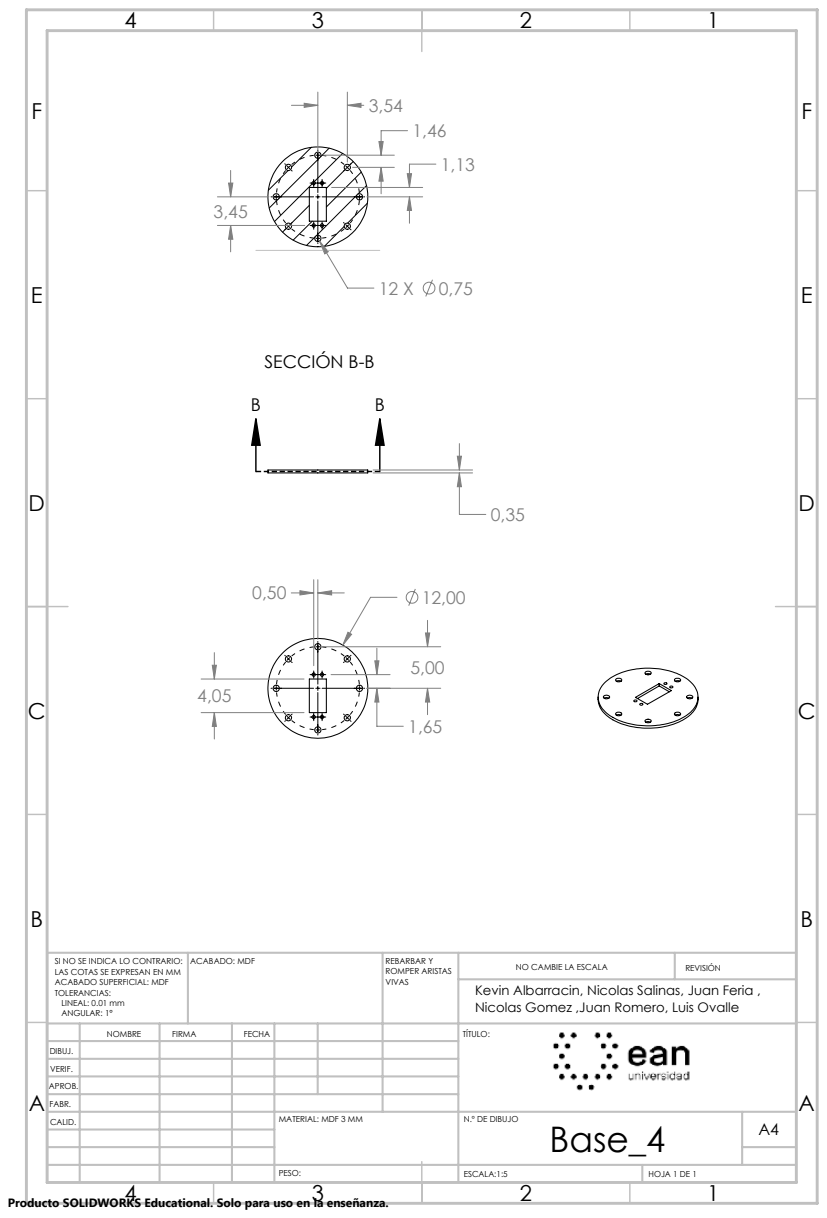
[picture p92: page 6]
SECCIÓN B-B; ACABADO: MDF; REBARBAR Y; ROMPER ARISTAS VIVAS; NO CAMBIE LA ESCALA; REVISIÓN

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

Kevin Albarracin, Nicolas Salinas, Juan Feria ,
Nicolas Gomez ,Juan Romero, Luis Ovalle

NOMBRE | FIRMA | FECHA | | | | TÍTULO:

DIBUJ.
VERIF.
APROB.
FABR.

MATERIAL: MDF 3 MM | Base_4

ESCALA:1:5 | HOJA 1 DE 1

0,60

1,90

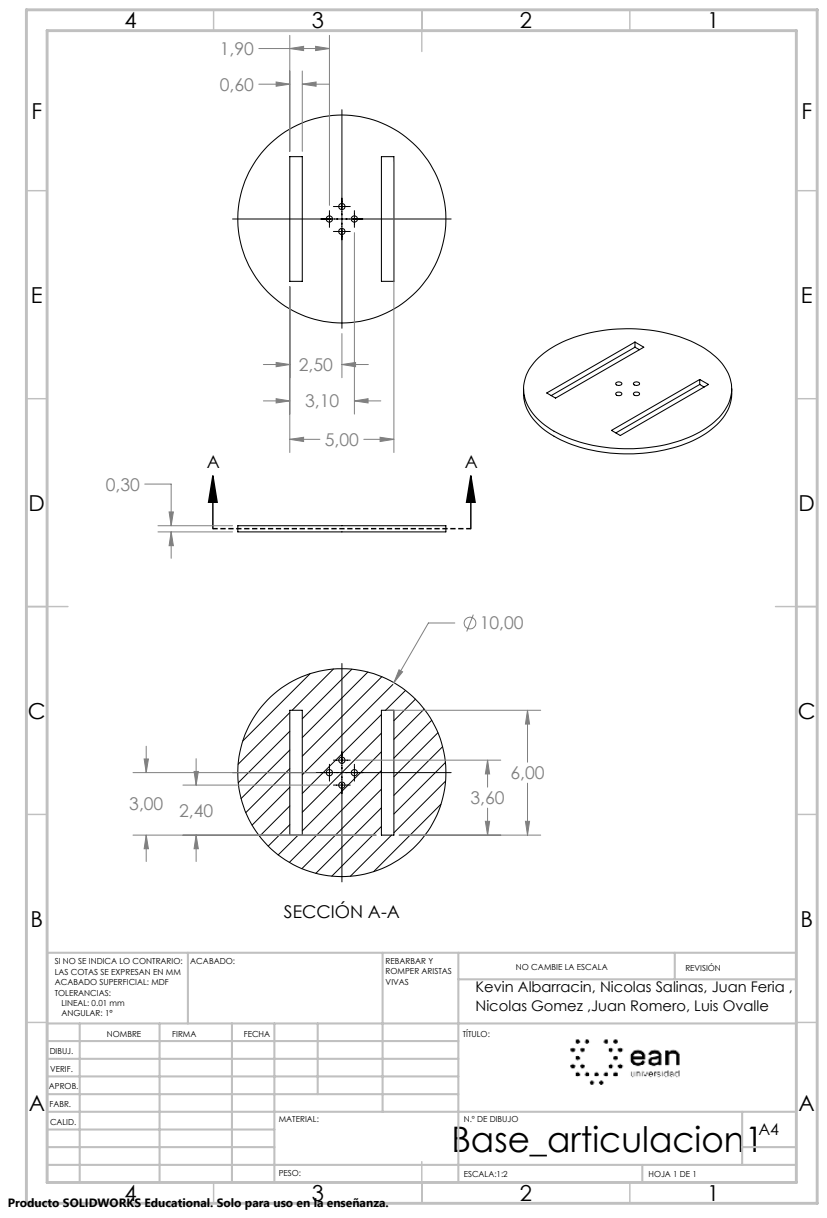
[picture p93: page 7]
SECCIÓN A-A; ACABADO:; REBARBAR Y; ROMPER ARISTAS VIVAS; NO CAMBIE LA ESCALA; REVISIÓN

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

Kevin Albarracin, Nicolas Salinas, Juan Feria ,
Nicolas Gomez ,Juan Romero, Luis Ovalle

NOMBRE | FIRMA | FECHA | | | TÍTULO:

DIBUJ.
VERIF.
APROB.
FABR.

MATERIAL: Base_articulacion1

ESCALA:1:2 | HOJA 1 DE 1

2 X R20,00

40,50

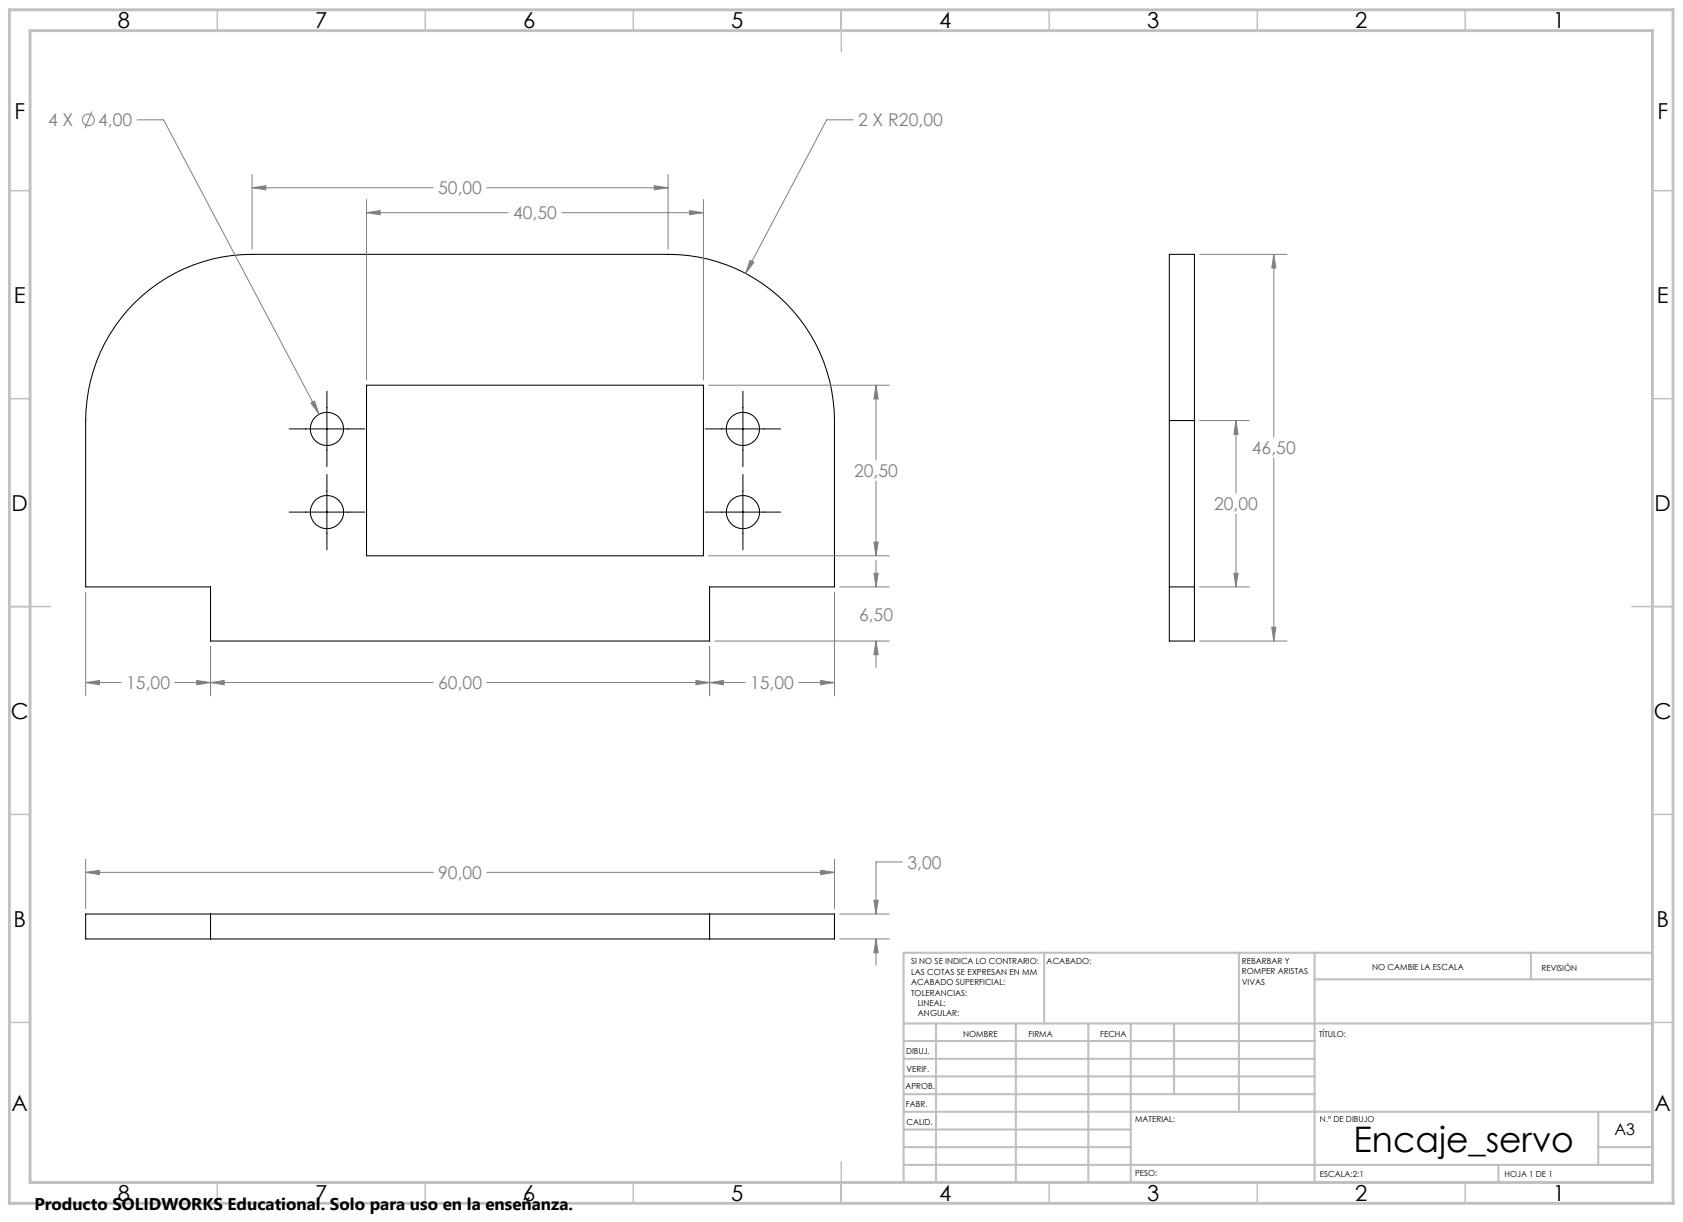
[picture p94: page 8]
ACABADO:; REBARBAR Y; ROMPER ARISTAS VIVAS; NO CAMBIE LA ESCALA; REVISIÓN

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

NOMBRE | FIRMA | FECHA | | | | TÍTULO:

DIBUJ.
VERIF.
APROB.
FABR.

MATERIAL: | Encaje_servo

ESCALA:2:1 | HOJA 1 DE 1

96,56
100,56

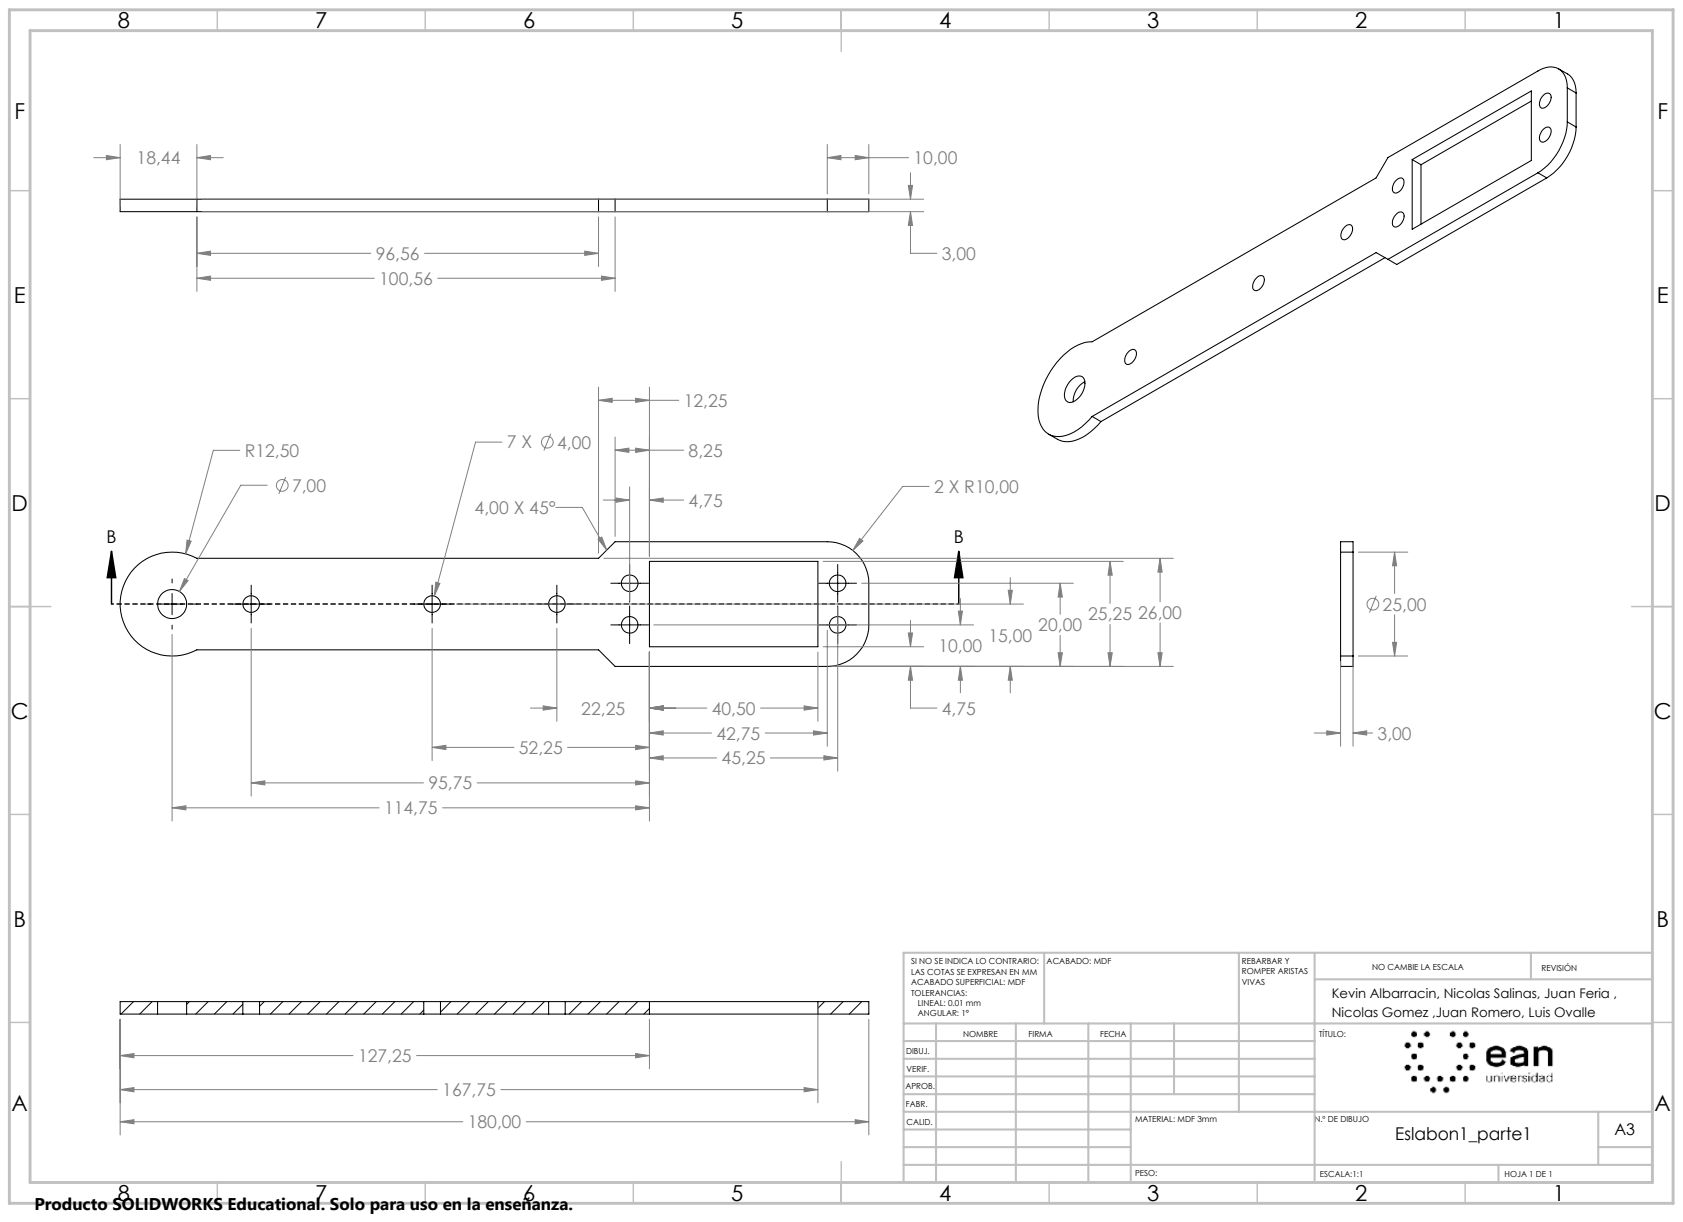
[picture p95: page 9]
ACABADO: MDF; REBARBAR Y; ROMPER ARISTAS VIVAS; NO CAMBIE LA ESCALA; REVISIÓN

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

Kevin Albarracin, Nicolas Salinas, Juan Feria ,
Nicolas Gomez ,Juan Romero, Luis Ovalle

NOMBRE | FIRMA | FECHA | | | | TÍTULO:

DIBUJ.
VERIF.
APROB.
FABR.

MATERIAL: MDF 3mm | Eslabon1_parte1

ESCALA:1:1 | HOJA 1 DE 1

96,56

100,56

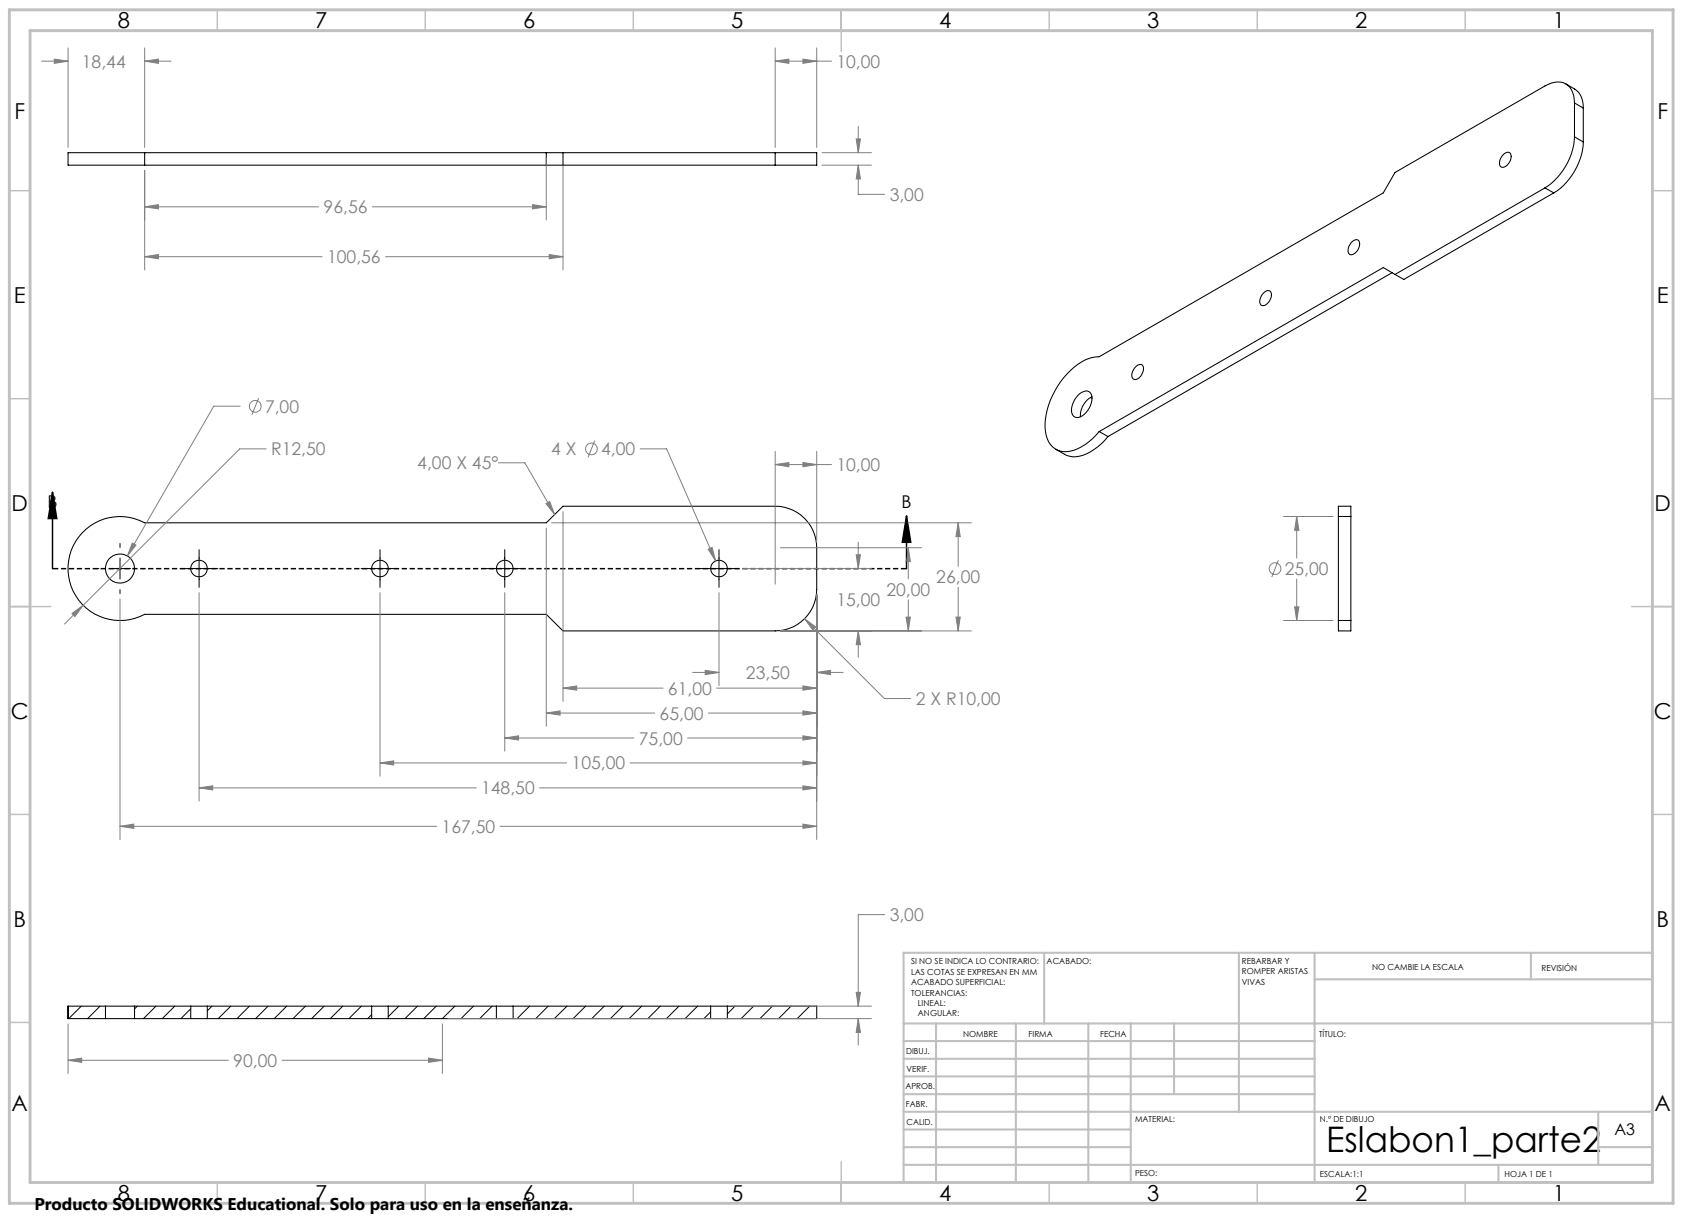
[picture p96: page 10]
ACABADO:; REBARBAR Y; ROMPER ARISTAS VIVAS; NO CAMBIE LA ESCALA; REVISIÓN

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

NOMBRE | FIRMA | FECHA | | | | TÍTULO:

DIBUJ.
VERIF.
APROB.
FABR.

MATERIAL: | Eslabon1_parte2

ESCALA:1:1 | HOJA 1 DE 1

80,00

23,29

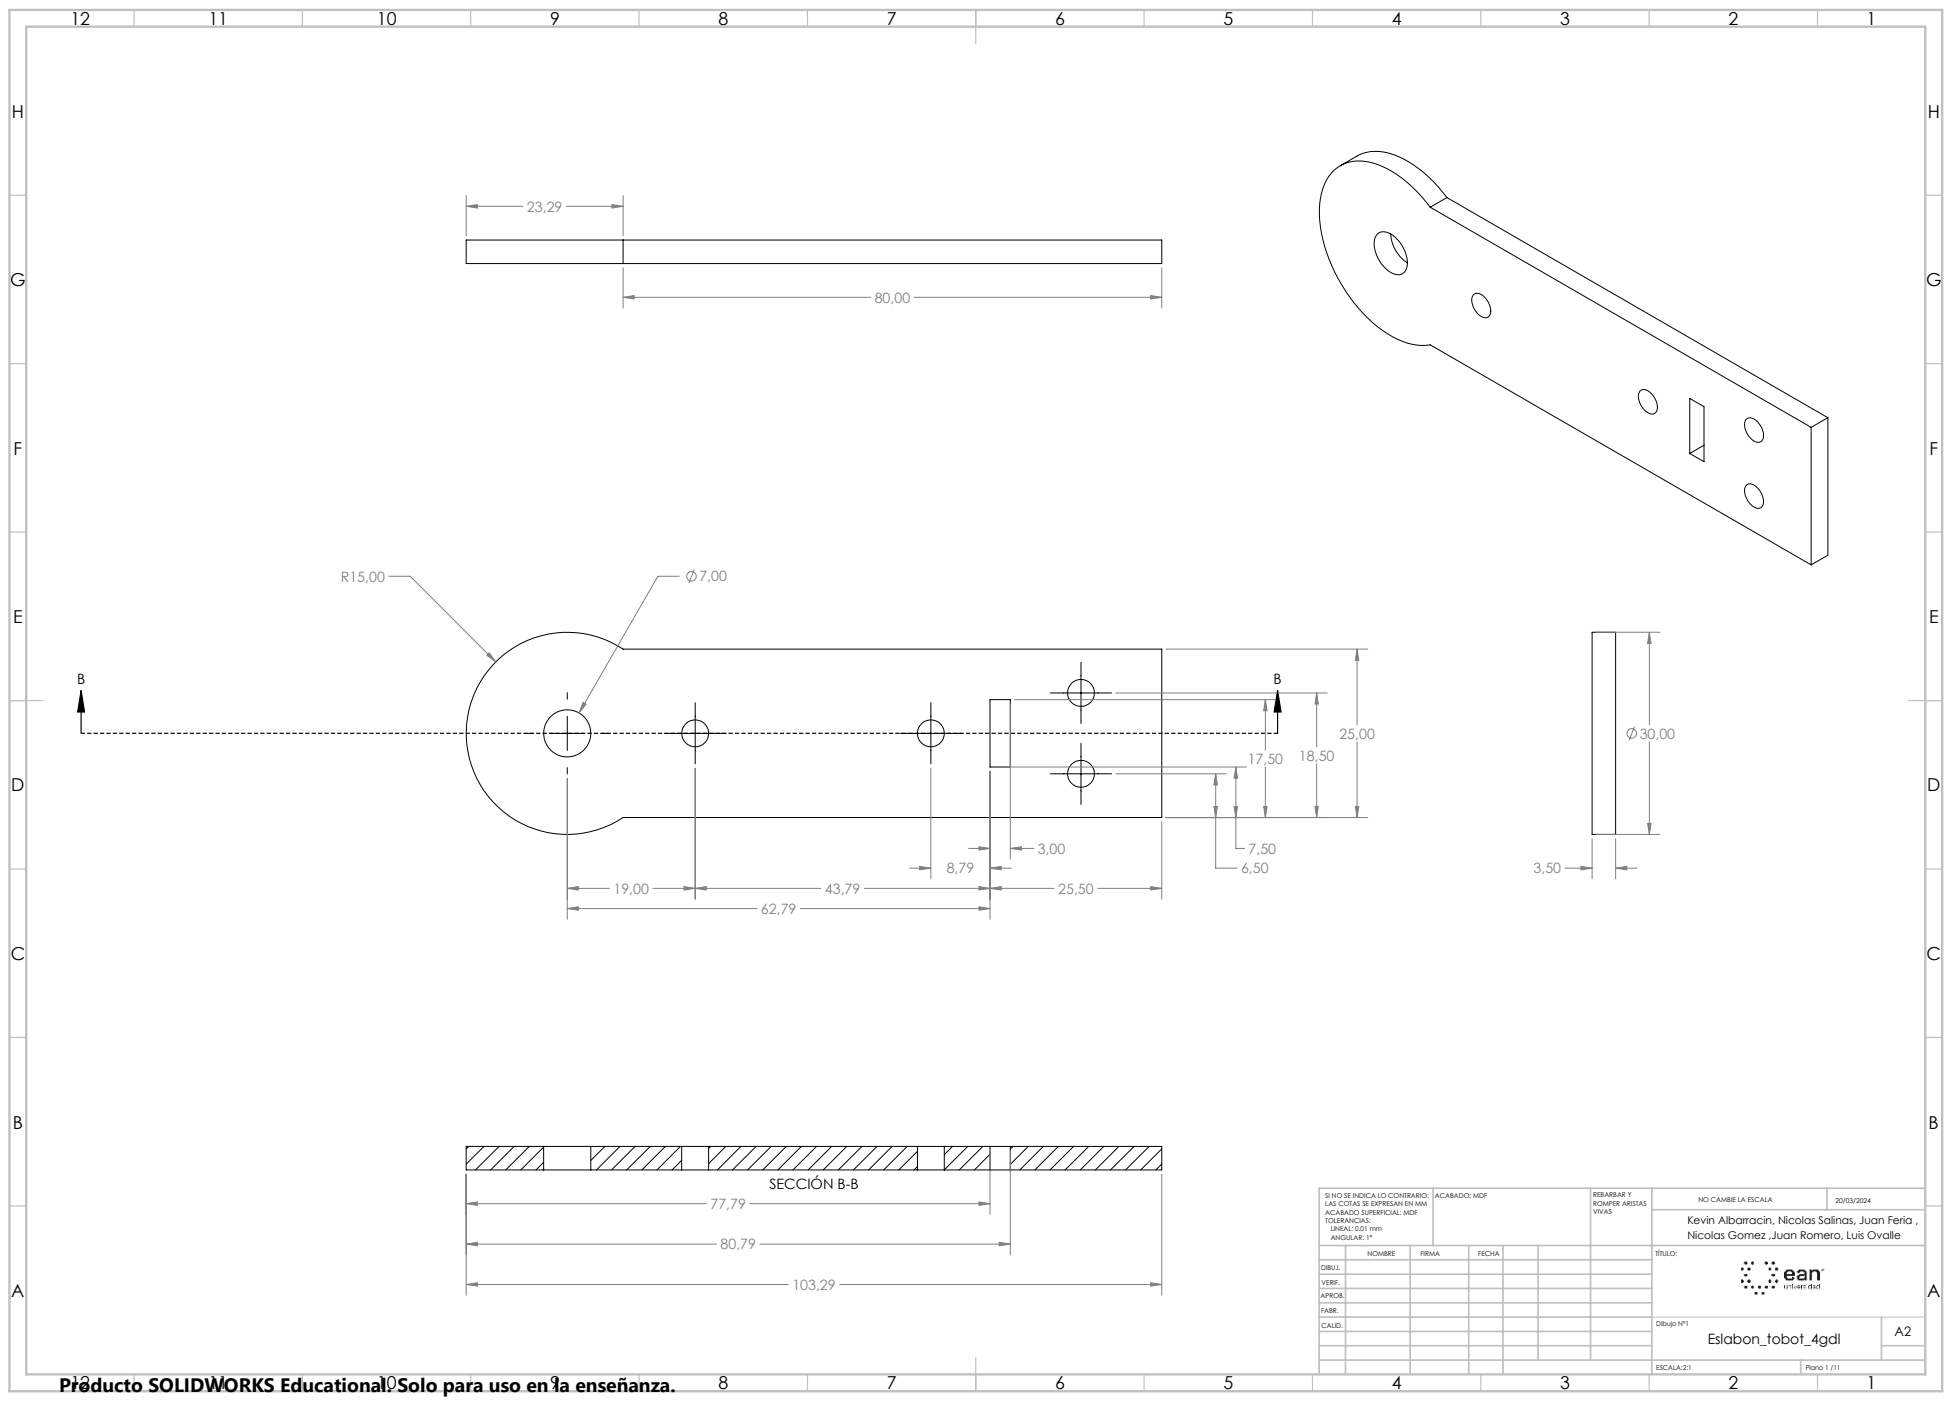
[picture p97: page 11]
SECCIÓN B-B

SI NO SE INDICA LO CONTRARIO: LAS COTAS SE EXPRESAN EN MM ACABADO SUPERFICIAL: MDF TOLERANCIAS: LINEAL: 0.01 mm ANGULAR: 1° | ACABADO: MDF | REBARBAR Y ROMPER ARISTAS VIVAS | NO CAMBIE LA ESCALA | 20/03/2024

Kevin Albarracin, Nicolas Salinas, Juan Feria ,
Nicolas Gomez ,Juan Romero, Luis Ovalle

NOMBRE | FIRMA | FECHA | | | TÍTULO:

DIBUJ.
VERIF.
APROB.
FABR.

Dibujo Nº1 | A2 Eslabon_tobot_4gdl

ESCALA:2:1 | Plano 1 /11

80,00

23,29

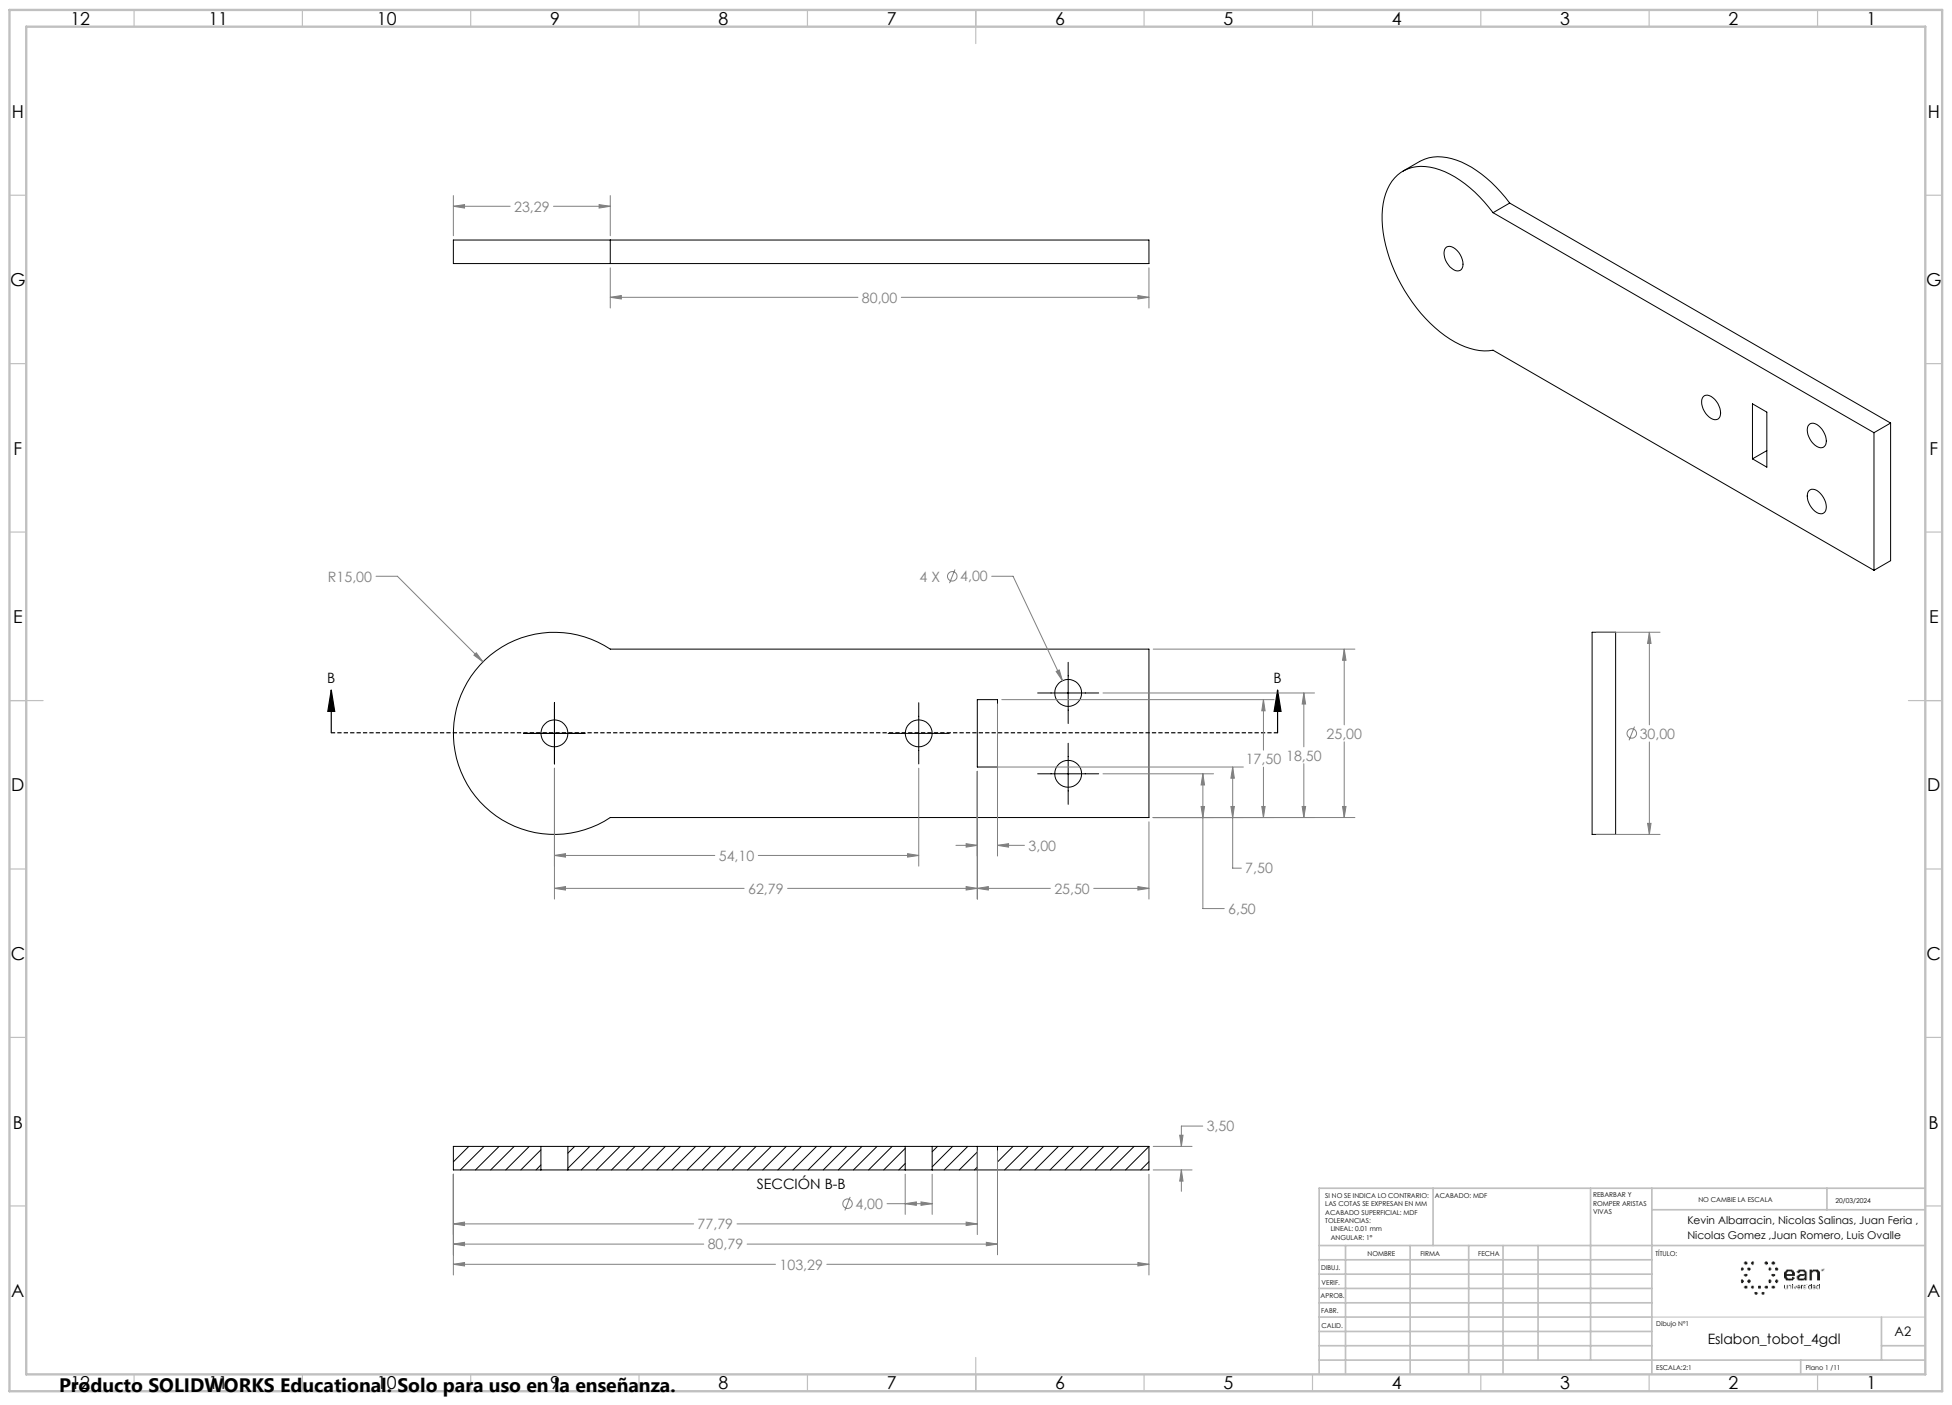
[picture p98: page 12]
SECCIÓN B-B

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

Kevin Albarracin, Nicolas Salinas, Juan Feria ,
Nicolas Gomez ,Juan Romero, Luis Ovalle

NOMBRE | FIRMA | FECHA | | | TÍTULO:

DIBUJ.
VERIF.
APROB.
FABR.

Dibujo Nº1 | A2 Eslabon_tobot_4gdl

ESCALA:2:1 | Plano 1 /11

0,30

1,00

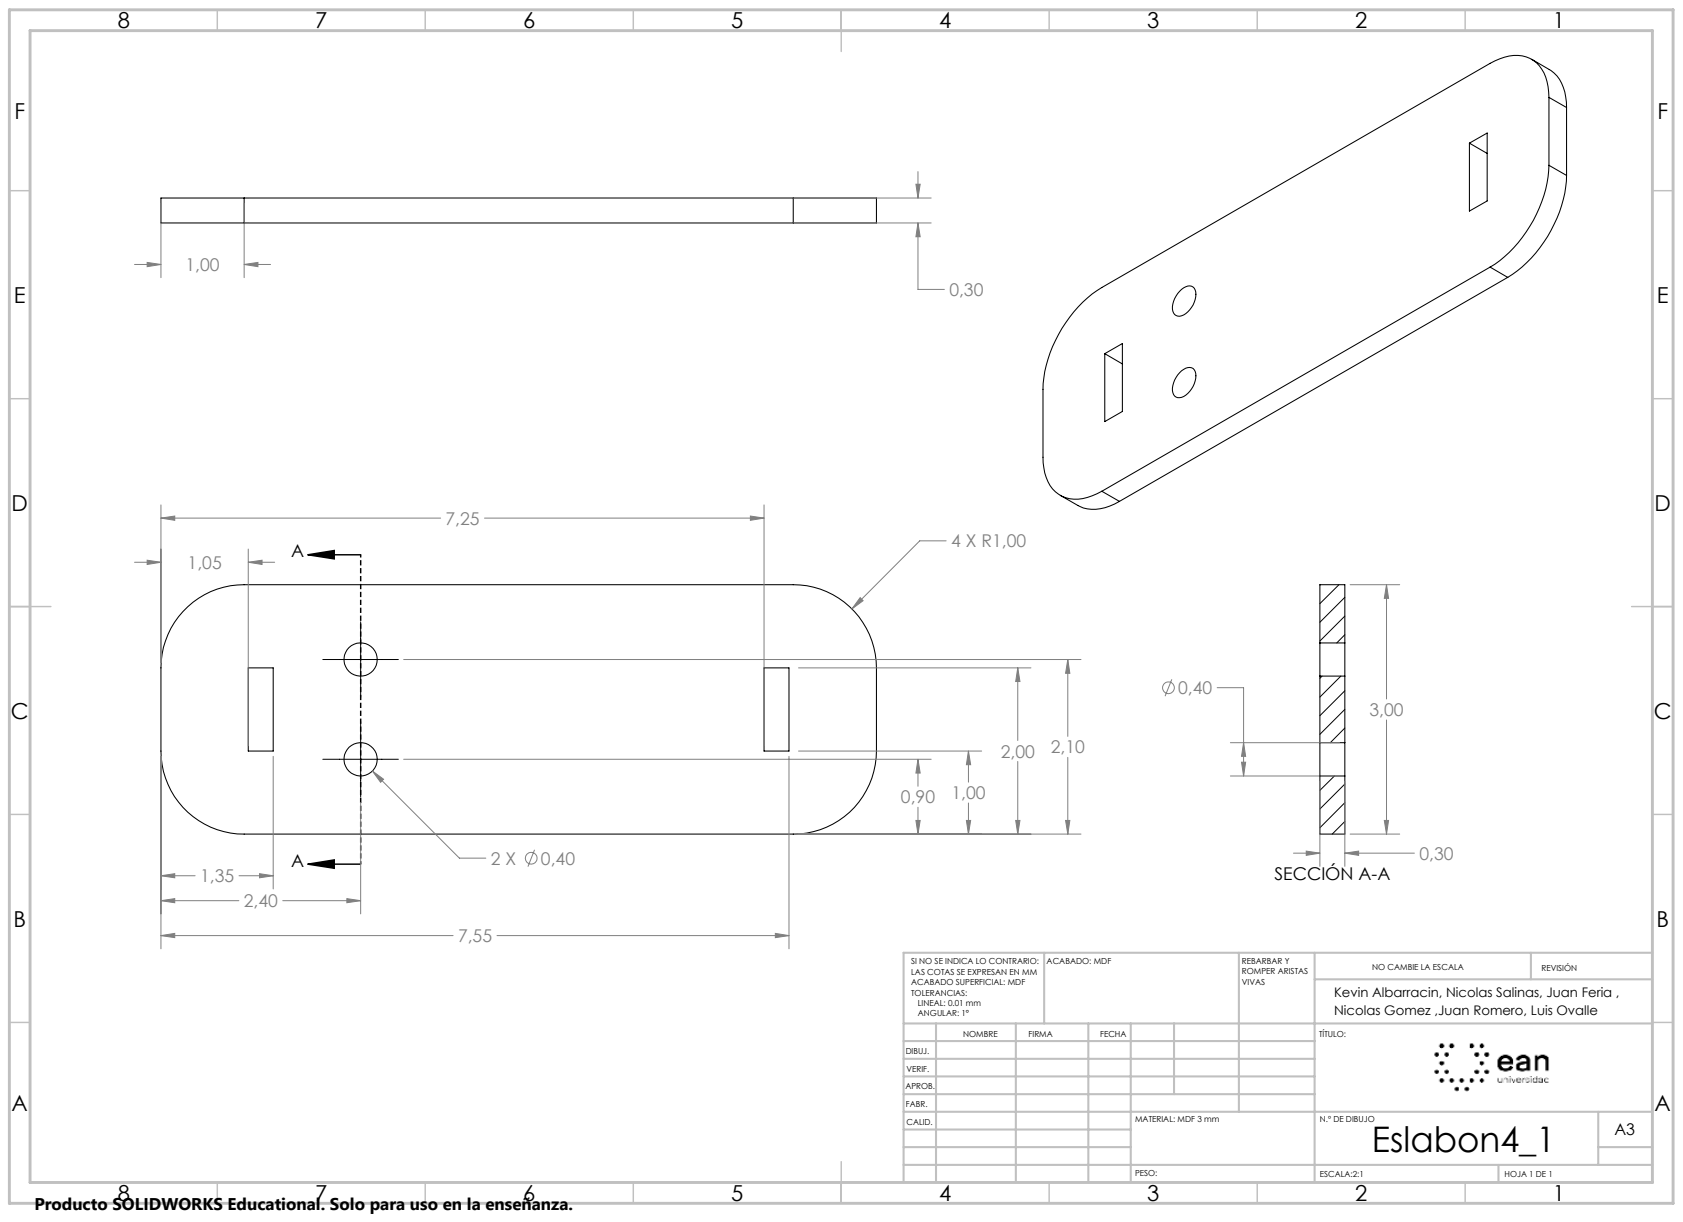
[picture p99: page 13]
SECCIÓN A-A; ACABADO: MDF; REBARBAR Y; ROMPER ARISTAS VIVAS; NO CAMBIE LA ESCALA; REVISIÓN

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

Kevin Albarracin, Nicolas Salinas, Juan Feria ,
Nicolas Gomez ,Juan Romero, Luis Ovalle

NOMBRE | FIRMA | FECHA | | | | TÍTULO:

DIBUJ.
VERIF.
APROB.
FABR.

MATERIAL: MDF 3 mm | Eslabon4_1

ESCALA:2:1 | HOJA 1 DE 1

0,30

0,40

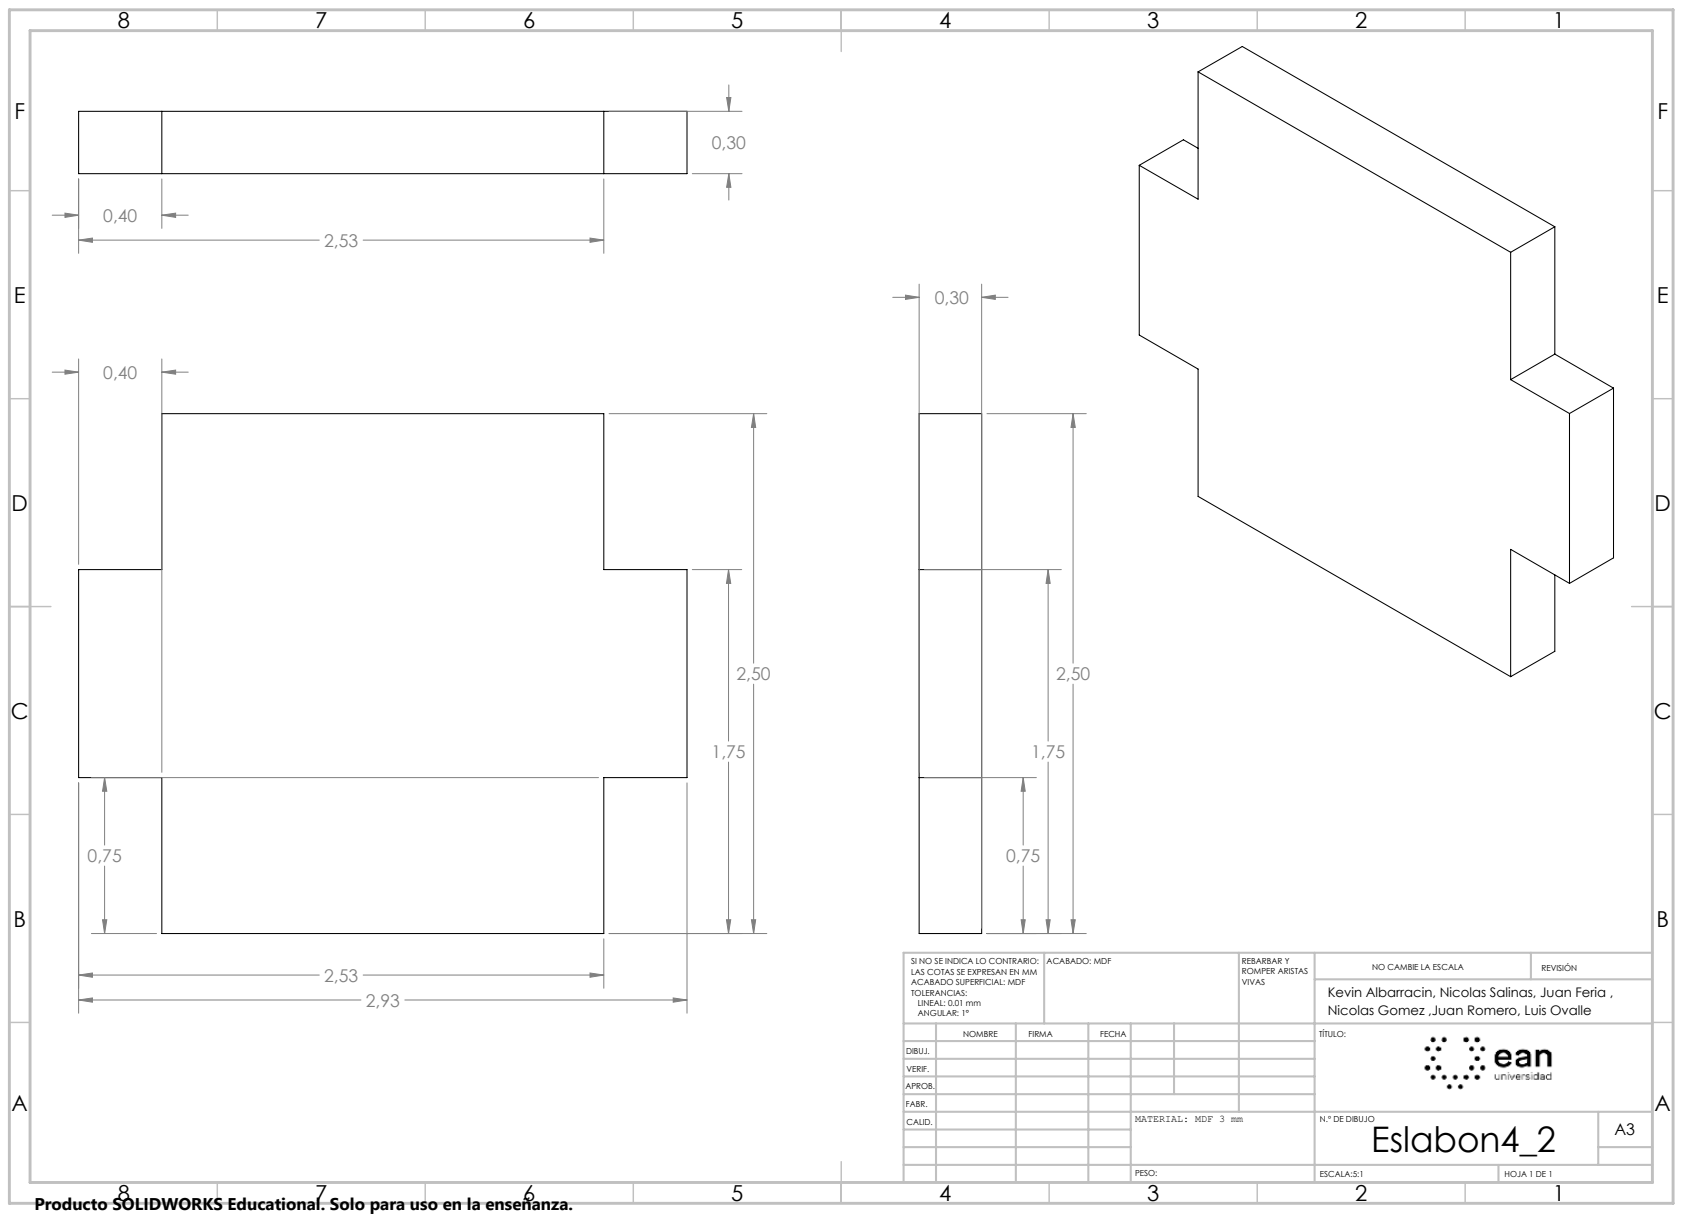
[picture p100: page 14]
ACABADO: MDF; REBARBAR Y; ROMPER ARISTAS VIVAS; NO CAMBIE LA ESCALA; REVISIÓN

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

Kevin Albarracin, Nicolas Salinas, Juan Feria ,
Nicolas Gomez ,Juan Romero, Luis Ovalle

NOMBRE | FIRMA | FECHA | | | | TÍTULO:

DIBUJ.
VERIF.
APROB.
FABR.

MATERIAL: MDF 3 mm | Eslabon4_2

ESCALA:5:1 | HOJA 1 DE 1

5,90

6,80

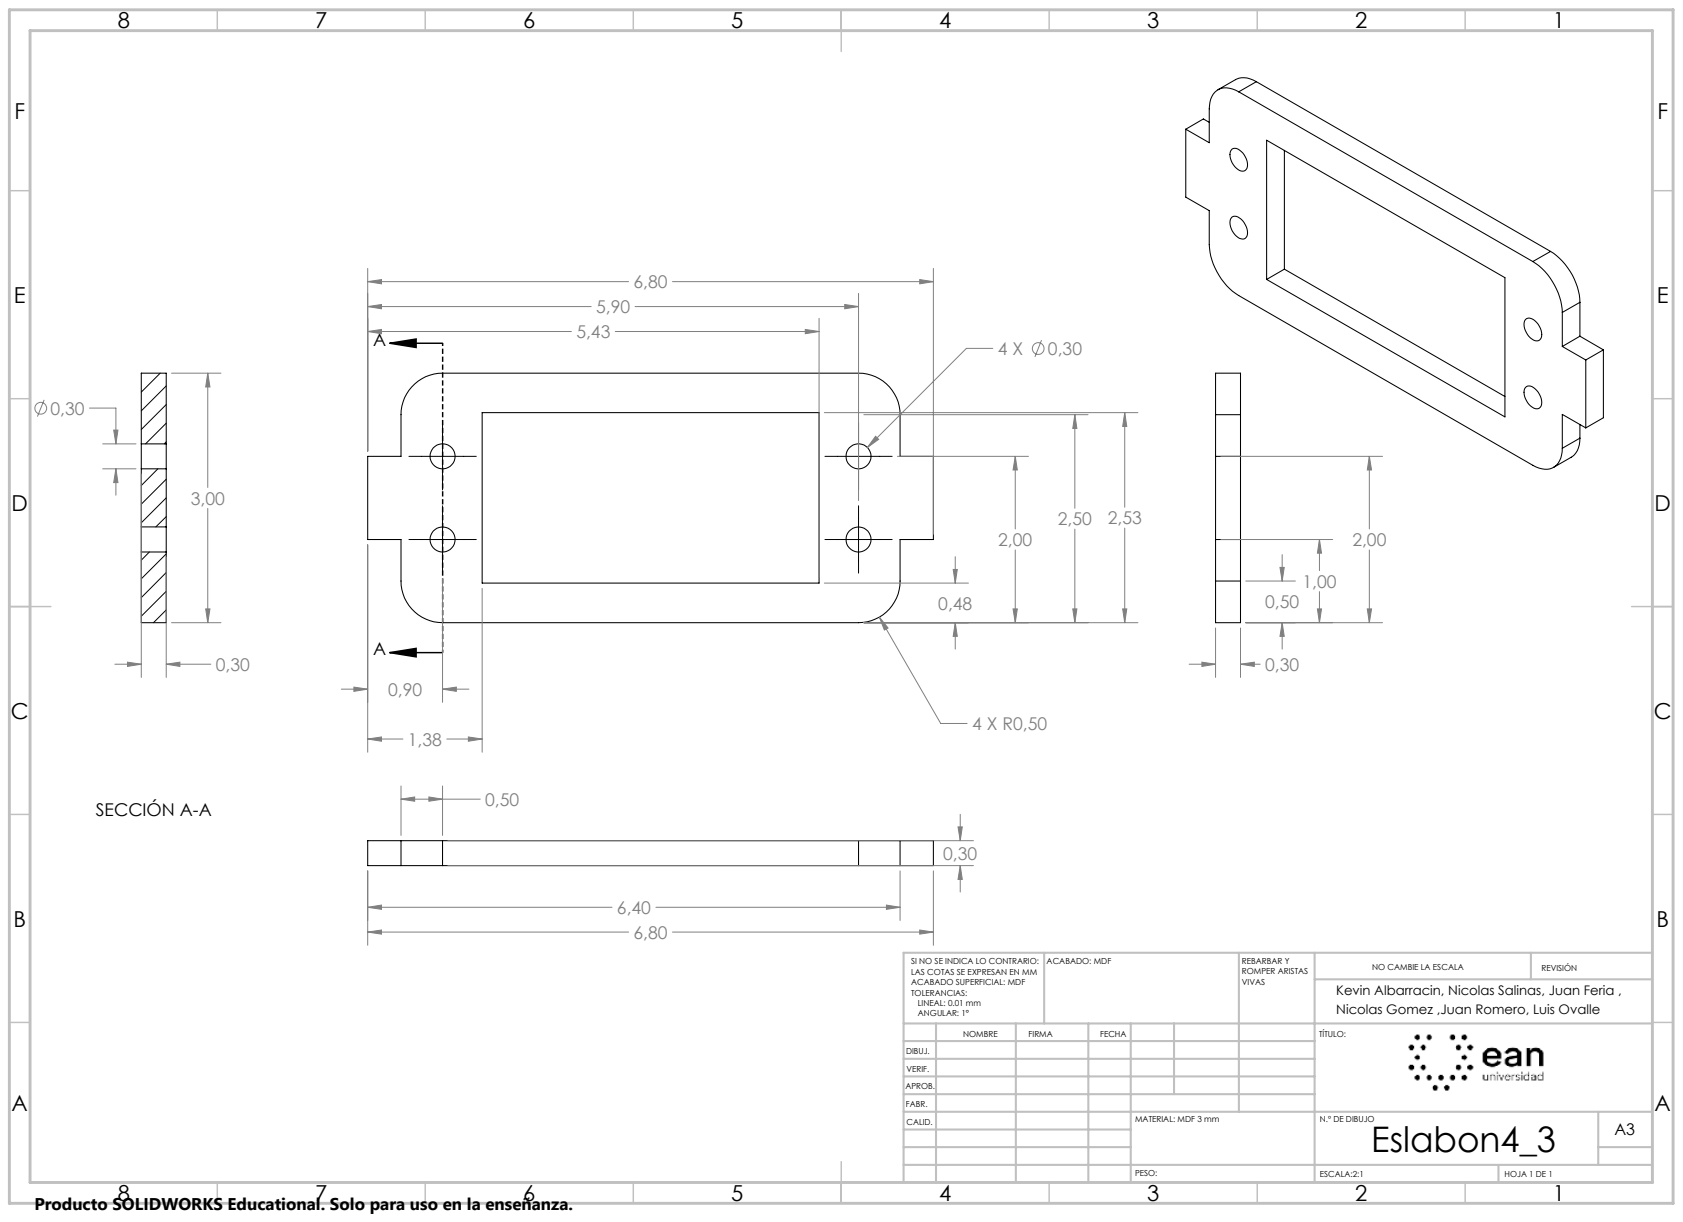
[picture p101: page 15]
SECCIÓN A-A; ACABADO: MDF; REBARBAR Y; ROMPER ARISTAS VIVAS; NO CAMBIE LA ESCALA; REVISIÓN

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

Kevin Albarracin, Nicolas Salinas, Juan Feria ,
Nicolas Gomez ,Juan Romero, Luis Ovalle

NOMBRE | FIRMA | FECHA | | | | TÍTULO:

DIBUJ.
VERIF.
APROB.
FABR.

MATERIAL: MDF 3 mm | Eslabon4_3

ESCALA:2:1 | HOJA 1 DE 1

E | E
F | F

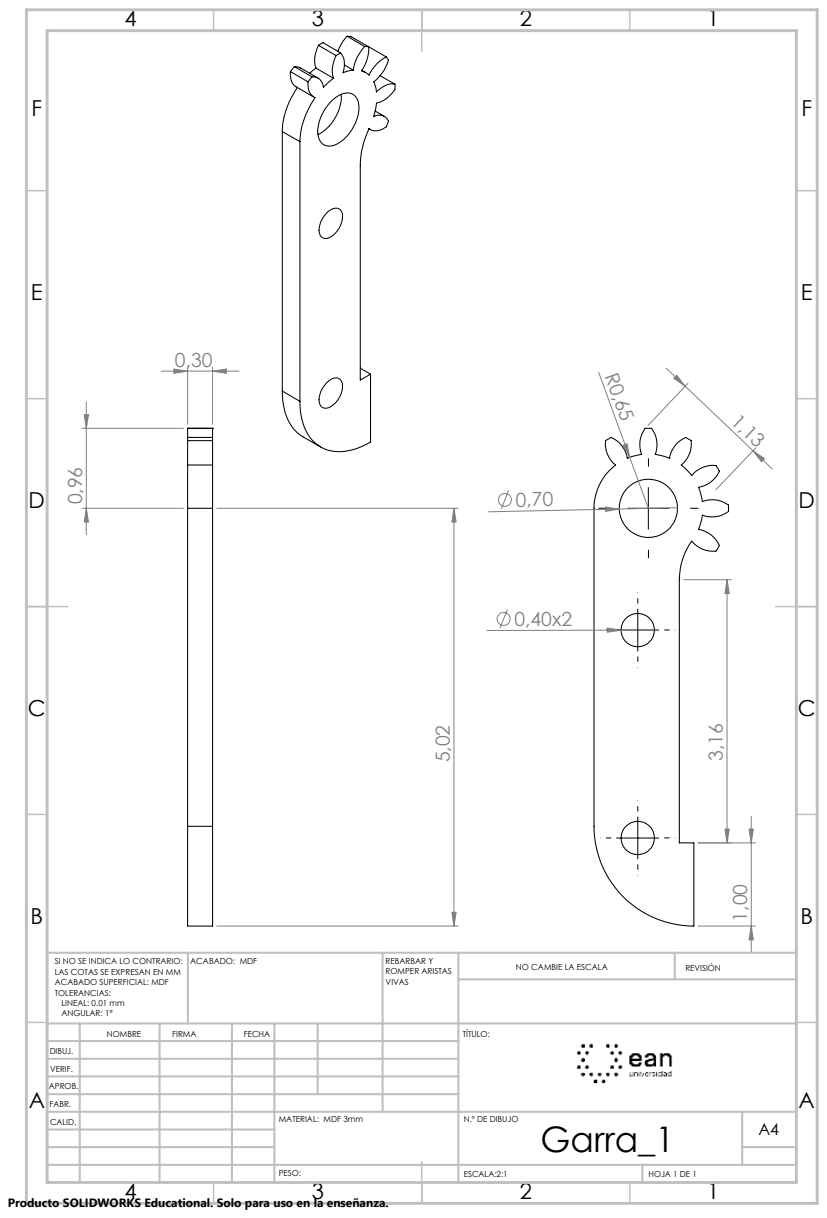
[picture p102: page 16]
ACABADO: MDF; REBARBAR Y; ROMPER ARISTAS VIVAS; NO CAMBIE LA ESCALA; REVISIÓN

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

NOMBRE | FIRMA | FECHA | | | | TÍTULO:

DIBUJ.
VERIF.
APROB.
FABR.

MATERIAL: MDF 3mm | Garra_1

ESCALA:2:1 | HOJA 1 DE 1

E | E
F | F

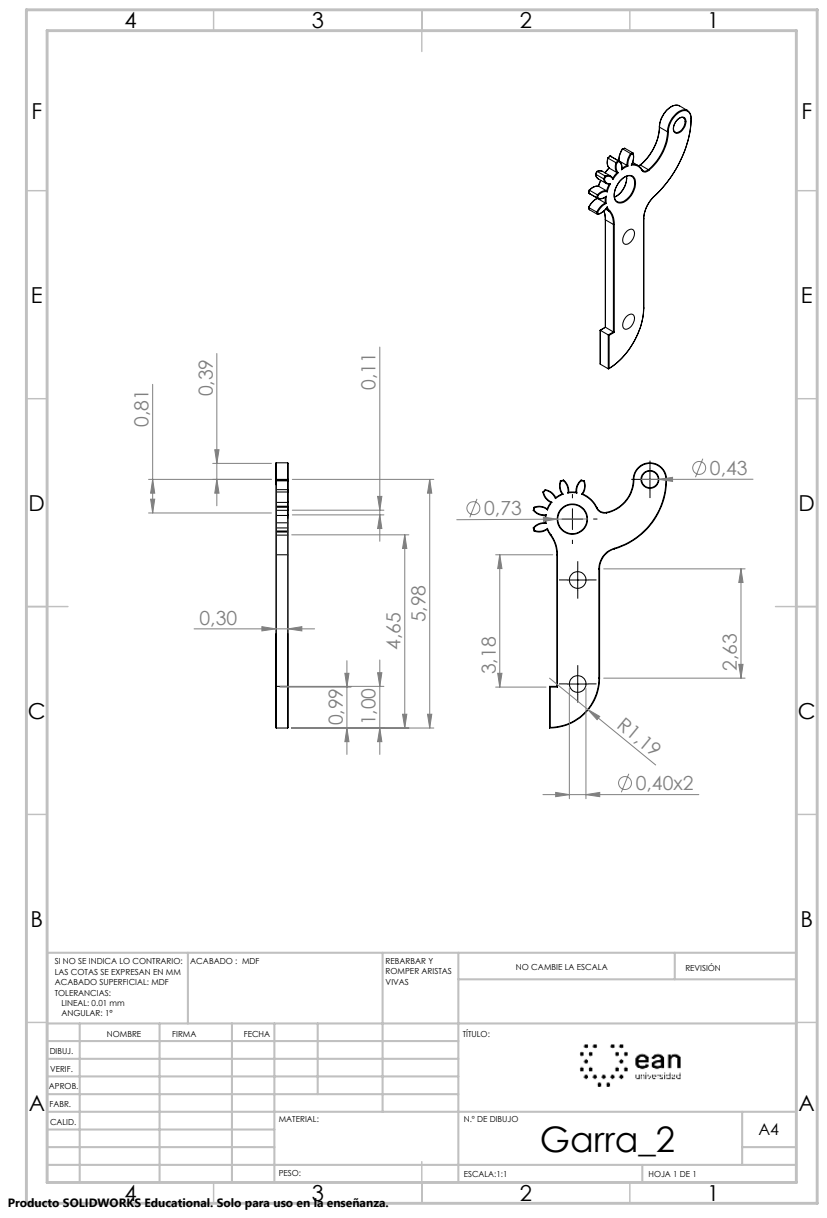
[picture p103: page 17]
ACABADO : MDF; REBARBAR Y; ROMPER ARISTAS VIVAS; NO CAMBIE LA ESCALA; REVISIÓN

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

NOMBRE | FIRMA | FECHA | | | | TÍTULO:

DIBUJ.
VERIF.
APROB.
FABR.

MATERIAL: | Garra_2

ESCALA:1:1 | HOJA 1 DE 1

12,75

5,00

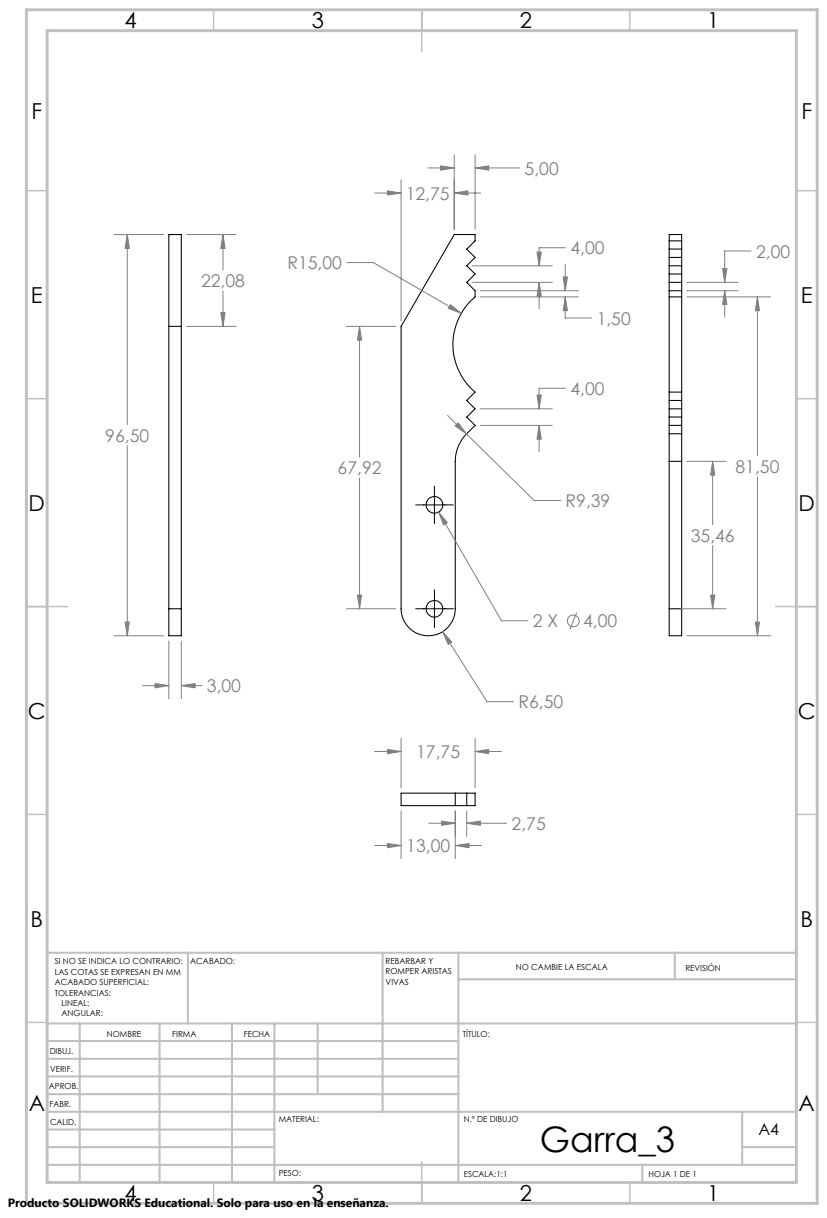
[picture p104: page 18]
ACABADO:; REBARBAR Y; ROMPER ARISTAS VIVAS; NO CAMBIE LA ESCALA; REVISIÓN

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

NOMBRE | FIRMA | FECHA | | | | TÍTULO:

DIBUJ.
VERIF.
APROB.
FABR.

MATERIAL: | Garra_3

ESCALA:1:1 | HOJA 1 DE 1

E | E
F | F

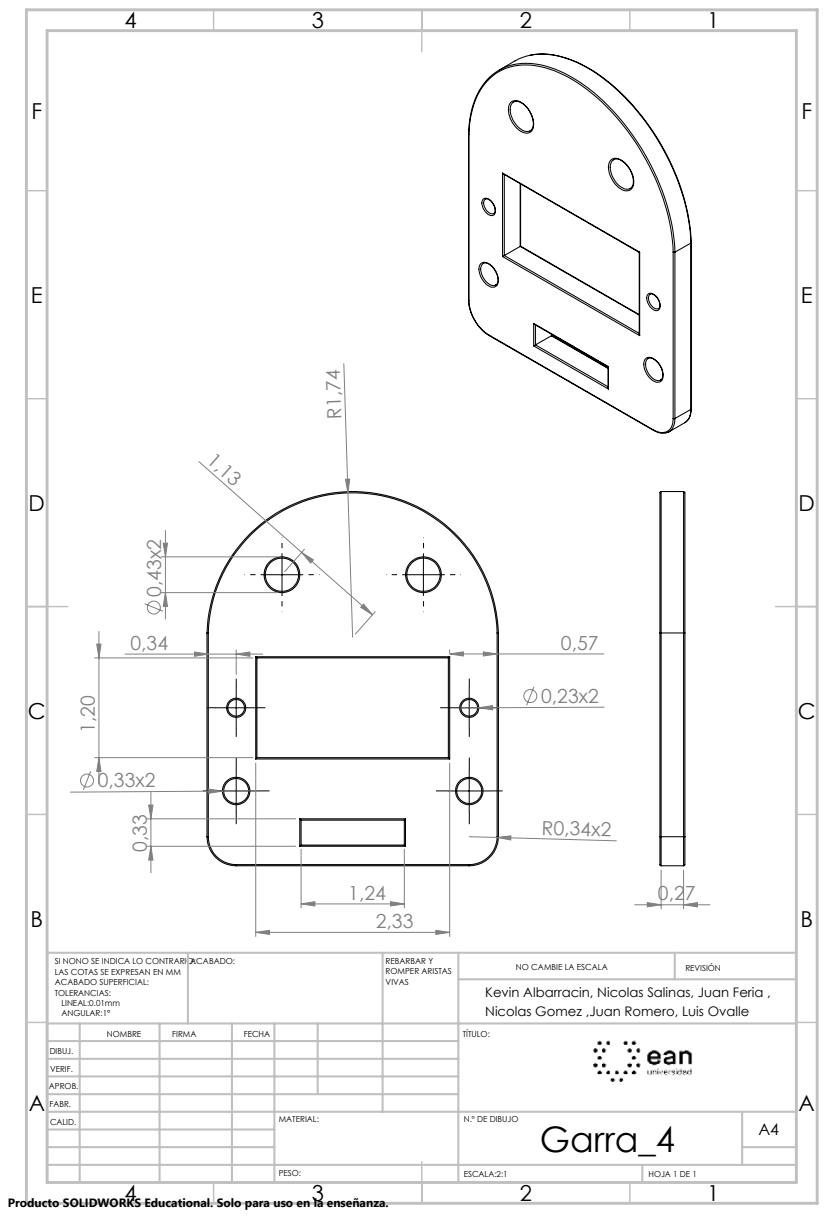
[picture p105: page 19]
ACABADO:; REBARBAR Y; ROMPER ARISTAS VIVAS; NO CAMBIE LA ESCALA; REVISIÓN

SI NONO SE INDICA LO CONTRARIO:
LAS COTAS SE EXPRESAN EN MM
ACABADO SUPERFICIAL:
TOLERANCIAS:
LINEAL:0.01mm
ANGULAR:1°

Kevin Albarracin, Nicolas Salinas, Juan Feria ,
Nicolas Gomez ,Juan Romero, Luis Ovalle

NOMBRE | FIRMA | FECHA | | | | TÍTULO:

DIBUJ.
VERIF.
APROB.
FABR.

MATERIAL: | Garra_4

ESCALA:2:1 | HOJA 1 DE 1

2,47

E | E

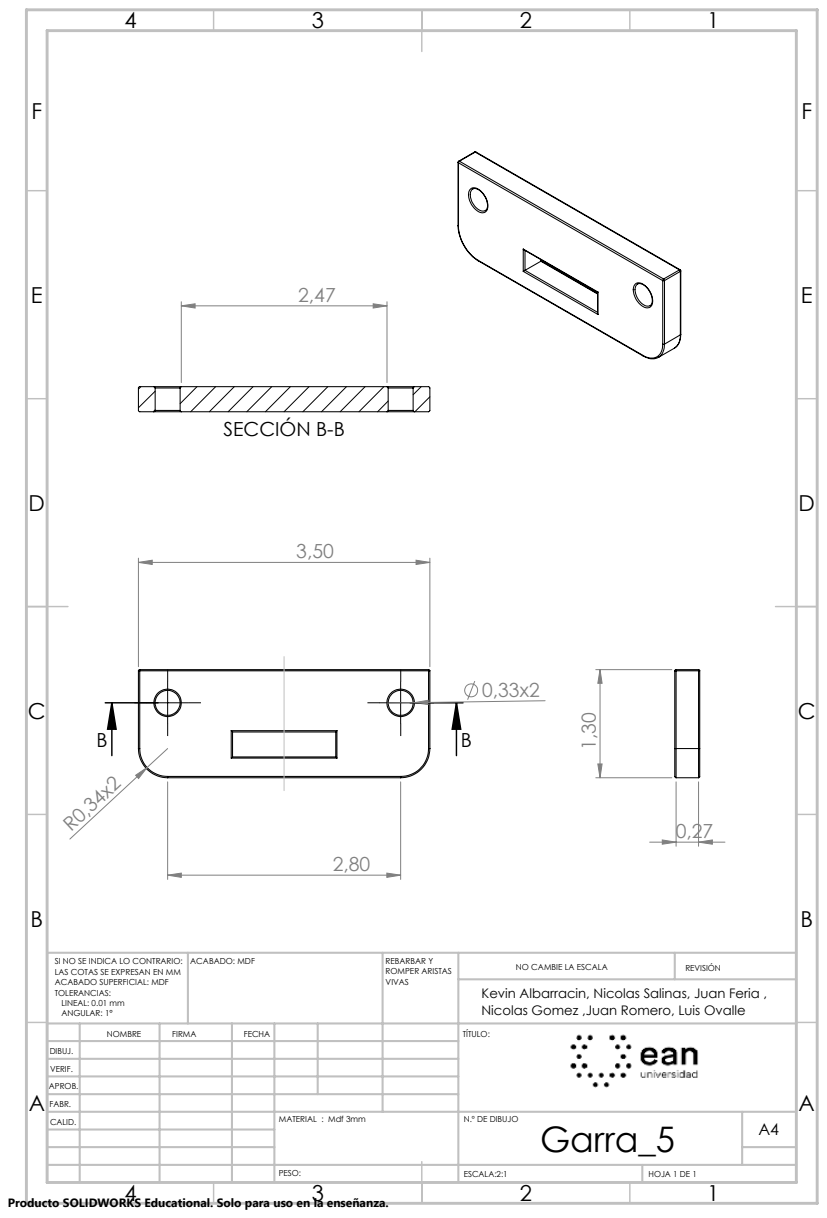
[picture p106: page 20]
SECCIÓN B-B; ACABADO: MDF; REBARBAR Y; ROMPER ARISTAS VIVAS; NO CAMBIE LA ESCALA; REVISIÓN

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

Kevin Albarracin, Nicolas Salinas, Juan Feria ,
Nicolas Gomez ,Juan Romero, Luis Ovalle

NOMBRE | FIRMA | FECHA | | | | TÍTULO:

DIBUJ.
VERIF.
APROB.
FABR.

MATERIAL : Mdf 3mm | Garra_5

ESCALA:2:1 | HOJA 1 DE 1

3,50
E | E

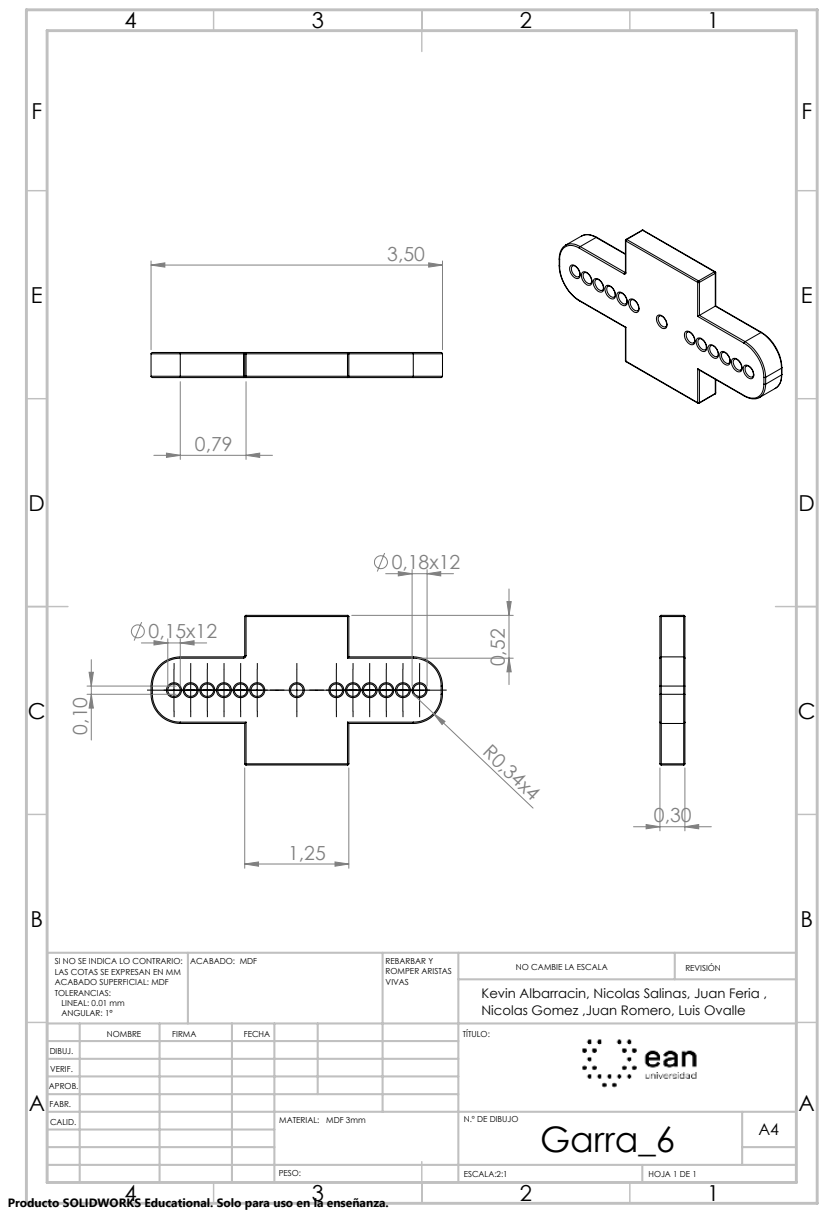
[picture p107: page 21]
ACABADO: MDF; REBARBAR Y; ROMPER ARISTAS VIVAS; NO CAMBIE LA ESCALA; REVISIÓN

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

Kevin Albarracin, Nicolas Salinas, Juan Feria ,
Nicolas Gomez ,Juan Romero, Luis Ovalle

NOMBRE | FIRMA | FECHA | | | | TÍTULO:

DIBUJ.
VERIF.
APROB.
FABR.

MATERIAL: MDF 3mm | Garra_6

ESCALA:2:1 | HOJA 1 DE 1

E | E
F | F

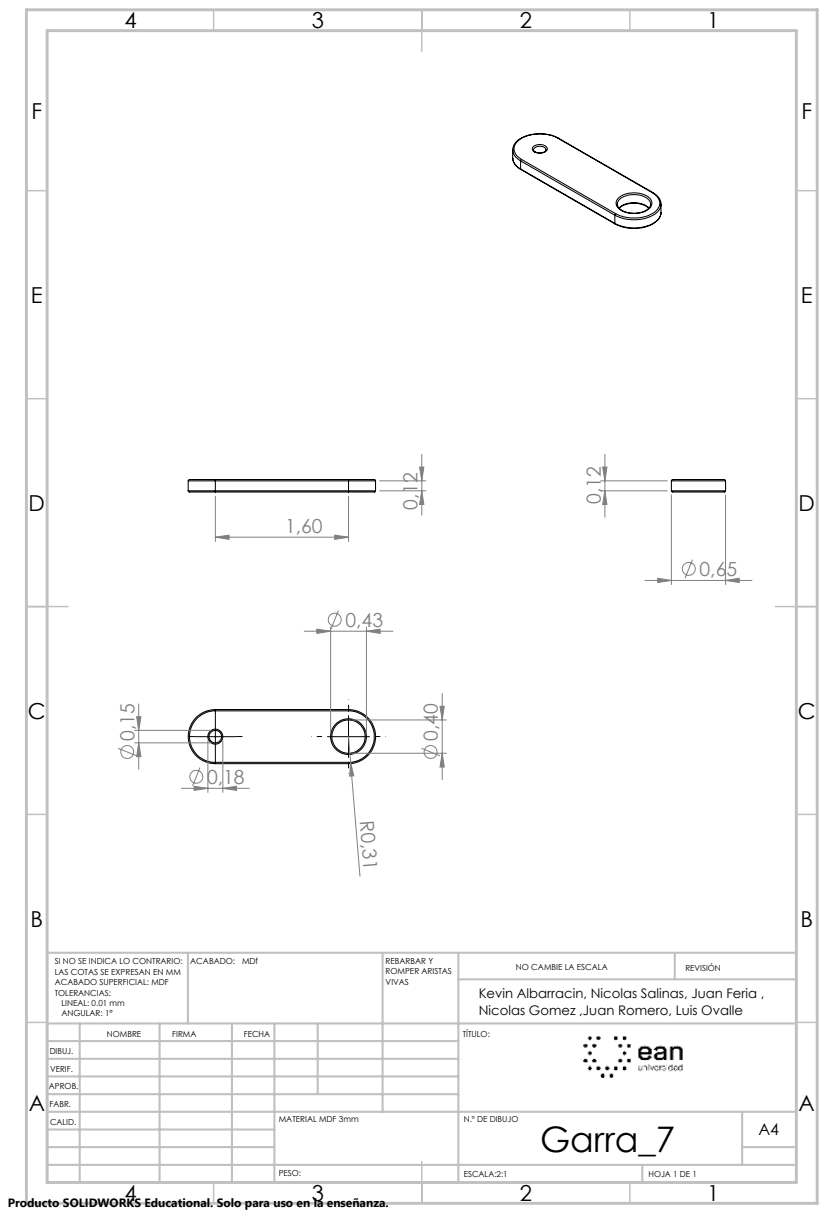
[picture p108: page 22]
ACABADO: MDf; REBARBAR Y; ROMPER ARISTAS VIVAS; NO CAMBIE LA ESCALA; REVISIÓN

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

Kevin Albarracin, Nicolas Salinas, Juan Feria ,
Nicolas Gomez ,Juan Romero, Luis Ovalle

NOMBRE | FIRMA | FECHA | | | | TÍTULO:

DIBUJ.
VERIF.
APROB.
FABR.

MATERIAL MDF 3mm | Garra_7

ESCALA:2:1 | HOJA 1 DE 1

8 X 0,40

G | G

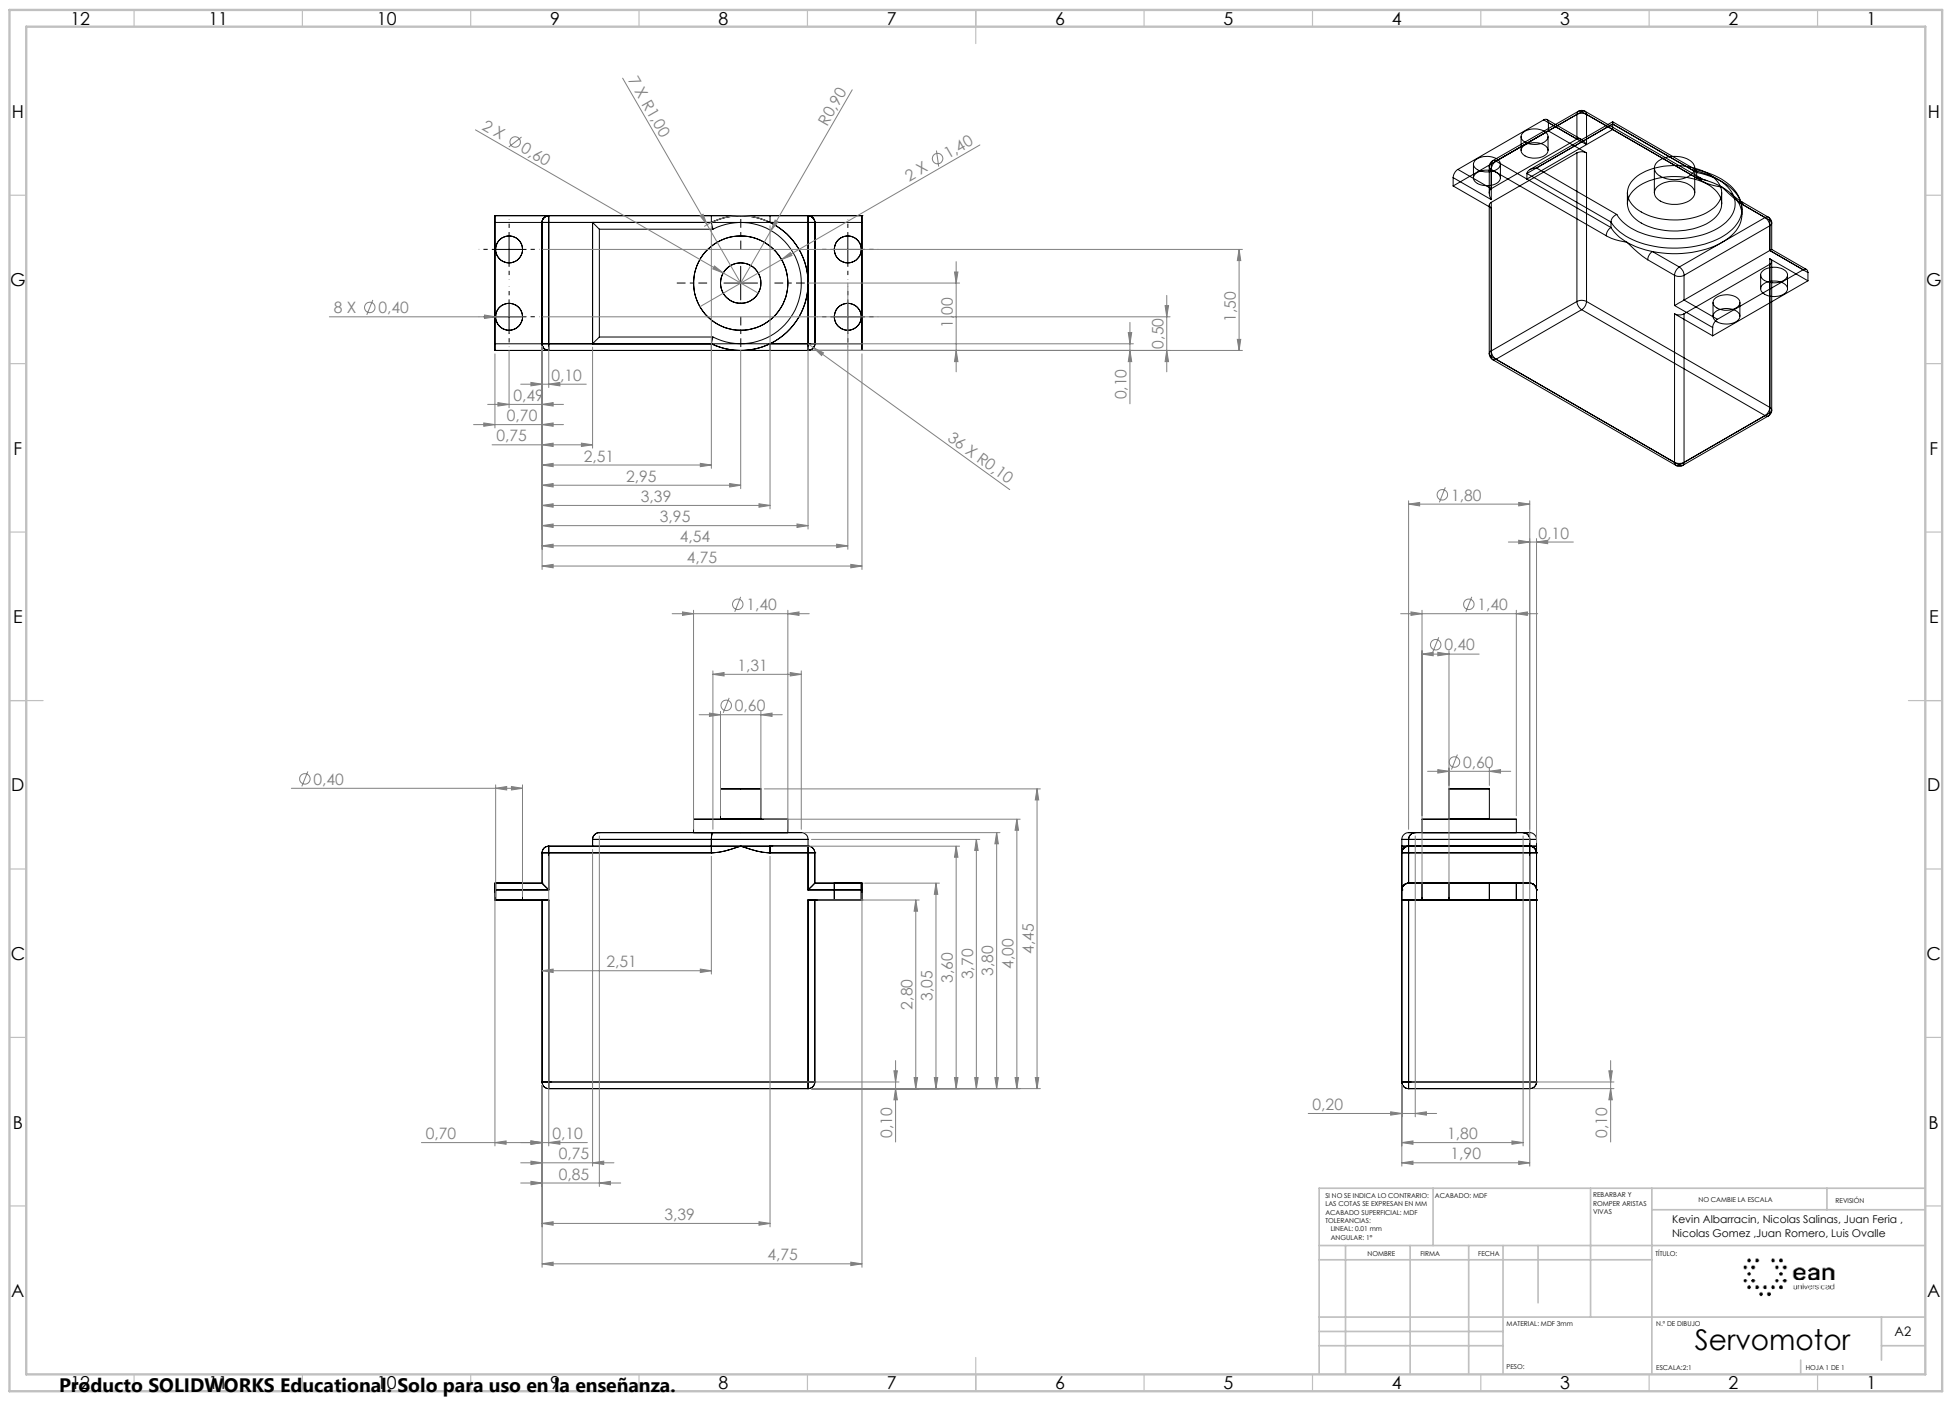
[picture p109: page 23]
ACABADO: MDF; REBARBAR Y; ROMPER ARISTAS VIVAS; NOMBRE; FIRMA; FECHA; MATERIAL: MDF 3mm; NO CAMBIE LA ESCALA; REVISIÓN; TÍTULO:; ESCALA:2:1; HOJA 1 DE 1; Servomotor

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

Kevin Albarracin, Nicolas Salinas, Juan Feria ,
Nicolas Gomez ,Juan Romero, Luis Ovalle
