NikPanda1537/Proyecto-Robotica-y-Dise-o-mecatronico/Planos/Todos los planos en pdf/Base_articulacion1.pdf

SECCIÓN A-A; ACABADO:; REBARBAR Y; ROMPER ARISTAS; NO CAMBIE LA ESCALA; REVISIÓN; ESCALA:1:2; HOJA 1 DE 1

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

Kevin Albarracin, Nicolas Salinas, Juan Feria ,
Nicolas Gomez ,Juan Romero, Luis Ovalle

NOMBRE | FIRMA | FECHA | | | | TÍTULO:

DIBUJ.
VERIF.
APROB.
FABR.
CALID. | | | | MATERIAL: Base_articulacion1 | N.º DE DIBUJO | A4

Producto SOLIDWORKS Educational. Solo para uso en la enseñanza.
