NikPanda1537/Proyecto-Robotica-y-Dise-o-mecatronico/Planos/Todos los planos en pdf/Eslabon1_parte1.pdf

ACABADO: MDF; REBARBAR Y; ROMPER ARISTAS; NO CAMBIE LA ESCALA; REVISIÓN; ESCALA:1:1; HOJA 1 DE 1

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

Kevin Albarracin, Nicolas Salinas, Juan Feria ,
Nicolas Gomez ,Juan Romero, Luis Ovalle

NOMBRE | FIRMA | FECHA | | | | TÍTULO:

DIBUJ.
VERIF.
APROB.
FABR.
CALID. | | | | MATERIAL: MDF 3mm | N.º DE DIBUJO Eslabon1_parte1 | A3

Producto SOLIDWORKS Educational. Solo para uso en la enseñanza.
