NikPanda1537/Proyecto-Robotica-y-Dise-o-mecatronico/Planos/Todos los planos en pdf/Servomotor.pdf

ACABADO: MDF; REBARBAR Y; ROMPER ARISTAS; MATERIAL: MDF 3mm; NO CAMBIE LA ESCALA; REVISIÓN; N.º DE DIBUJO; ESCALA:2:1; HOJA 1 DE 1

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

Kevin Albarracin, Nicolas Salinas, Juan Feria ,
Nicolas Gomez ,Juan Romero, Luis Ovalle

Producto SOLIDWORKS Educational. Solo para uso en la enseñanza.
