NikPanda1537/Proyecto-Robotica-y-Dise-o-mecatronico/(commit log)

2024-06-11 Proyecto
    Documentacion
    [Base.SLDDRW, Base1.SLDDRW, Base2.SLDDRW, Base3.SLDDRW, Base_1.SLDPRT, Base_1x1.DXF, Base_2.SLDPRT, Base_2x1.DXF]
2024-06-11 Archivos URDF
    Documentación
    [Base.SLDPRT, Ensamblaje.SLDASM, Eslabon pinza.SLDPRT, Eslabon1.SLDPRT, Eslabon2.SLDPRT, Link_2.STL, Link_3.STL, Link_4.STL]
2024-06-12 Correcciones
    Verificación y corrección de planos
    [Base.SLDDRW, Base1.SLDDRW, Base2.SLDDRW, Base3.SLDDRW, Base_1.SLDDRW, Base_2.SLDDRW, Base_3.SLDDRW, Base_4.SLDDRW]
2024-06-12 Informes
    Reporte de robótica
2024-06-12 Corrección de archivos URDF
    [Archivos_URDF.csv, Archivos_URDF.urdf, Link_2.STL, Link_3.STL, Link_4.STL, Link_5.STL, Link_6.STL, Link_7.STL]
2024-06-12 Documentos de ROS
    [Archivos_URDF.urdf, Link_2.STL, Link_3.STL, Link_4.STL, Link_5.STL, Link_6.STL, Link_7.STL, base_link.STL]
